myk410/Material-Weight-Calculator/README.md

# Material Weight Calculator

A standalone pocket calculator for estimating material weight. Select a material, enter length, width, and thickness in inches, and read the result in pounds. Runs entirely on one microcontroller with physical buttons and replaceable AAA batteries.

Status: **R3 LTC3440 buck-boost PCB implemented and CAD-validated, November 12, 2026; FABRICATION HOLD.** See [R3 review, evidence and unresolved physical checks](hardware/R3_REVIEW.md) and open [the R3 KiCad project](hardware/pcb/r3/material_weight_calculator.kicad_pro). Both current R3 boards use SMD resistors, capacitors, transistors, diodes and inductors; the purchased AVR DIP/socket and connectors are retained. See [owned-parts policy](hardware/OWNED_PARTS_AND_SMD.md). Main and display-adapter boards pass KiCad 9 ERC, DRC and schematic parity with zero violations. No R3 Gerbers/drills/order ZIP have been released because real-part mating and fit checks remain open. Existing R2 manufacturing archives use MCP1700 and must not be ordered as R3. Firmware, prototype operation and battery life remain untested.

## Proposed final low-power hardware

| Part | Proposed choice | Reason |
| --- | --- | --- |
| Controller | Microchip AVR128DA28, preferably the through-hole package for a hand-built prototype | One low-power microcontroller; enough RAM for a graphical display; internal oscillator; no wireless hardware needed |
| Display | EastRising ERC12864FS-655, 2.8-inch 128 × 64 positive monochrome LCD, no touch panel | Larger black-on-light screen; operate with backlight disconnected; separate UC1701 adapter PCB included |
| Buttons | Sixteen flexible-resin button caps over the user-owned DIYmalls 4 × 4 membrane keypad | Sixteen physical keys using eight controller pins; no separate keypad processor |
| Batteries | Three AAA alkaline cells in a replaceable holder | Switched supply; buck-boost conversion extends useful battery range, subject to diode drop and sag |
| Regulator | LTC3440EMS#PBF, MSOP-10, R3 | Nominal 3.3 V buck-boost with hand-solderable SMD supply components; see the R3 review for qualification limits |
| Supporting parts | Regulator input/output capacitors, local MCU decoupling, battery protection diode, display power transistor, service link, programming header | Reliable supply and a way to program the controller without leaving a USB interface powered |
| Housing | Rigid-resin printed calculator enclosure with accessible battery compartment | Large readable labels and easy battery replacement |

See [PARTS_LIST.md](PARTS_LIST.md) for previously purchased parts and the prototype route. The exact hardware R2 component and M2.5 fastener lists are in [hardware/README.md](hardware/README.md). The current R2 design uses the 70 × 50 mm EastRising display and a 70 × 18 mm adapter. The manufacturer lists up to 500 µA LCD current at 3.3 V; complete-device current and indoor readability still require a physical test.

The AVR128DA28 has 16 KB SRAM. A 128 × 64 monochrome framebuffer needs 1,024 bytes. PA1/PA2/PA3 drive clock/data/chip select, PA4 selects command/data, and PA5 resets the UC1701. The device needs firmware; the HTML calculator is a separate working example.

## Why memory LCD instead of e-paper?

| Display | Suitability |
| --- | --- |
| Reflective memory LCD | Recommended for calculator entry: quick digit updates, low power, readable by reflected light. Requires power and periodic display polarity inversion while displaying an image. |
| Black-and-white e-paper | Excellent for holding a result with display power removed. Updates are slower and may show ghosting or occasional full-screen flashes; partial-refresh behavior depends on the exact panel. |
| Reflective character LCD without a backlight | Worth considering if a cheaper, simpler text-only display is preferred. Select a specific low-power module before comparing total current; ordinary hobby modules are not all equally efficient. |

E-paper is compatible with a microcontroller and does not require a Raspberry Pi. For this device, fast keypad feedback makes memory LCD the stronger starting point. Neither unlit option is readable in darkness without external light.

## User operation

1. Press ON to wake the calculator.
2. Use MENU for material selection; 8/↑ and 2/↓ move through menus and ENTER selects. Default to the last material during the current powered session.
3. Choose solid rectangular stock or pipe using a short menu on the existing keypad.
4. For rectangular stock, enter length, width, and thickness in inches.
5. For pipe, enter length, actual outside diameter, and wall thickness (or inside diameter). Press ENTER after each input.
6. Show the material, dimensions, and estimated pounds, with the weight in the largest text.

Key functions: digits 0–9, decimal point, ENTER, MENU, BACK, CLEAR, and ON/OFF. This fits a 16-key matrix. The printed button caps will be made in rubbery resin, with recessed legends, and will actuate electrical switches underneath. See [MECHANICAL_DESIGN.md](MECHANICAL_DESIGN.md) for the key layout and printing requirements.

BACK deletes the last digit; with an empty field it returns to the previous field. CLEAR empties the current entry; on the result screen it starts a new piece while retaining the selected material and shape. ON/OFF puts the calculator to sleep. Do not use long-press combinations for routine entry. Start with decimal inches; fraction entry can be added if needed after testing the controls.

Reject empty fields, zero or negative dimensions, malformed numbers, overflow, and values beyond the supported input range. Display an explicit error instead of a plausible-looking weight. Always label the result as an estimate.

## Calculation and material data

For a solid rectangular piece:

`weight_lb = length_in × width_in × thickness_in × density_lb_per_ft3 / 1728`

Example using the published carbon-steel density of 7,850 kg/m³ (about 490.059 lb/ft³): a 12 × 12 × 1-inch plate weighs about 40.838 lb, displayed as `40.84 lb`.

The HTML now supports rectangular stock, pipe/round tube, and known volume. Pipe volume is `π × wall × (OD − wall) × length`, or equivalently `π/4 × (OD − ID) × (OD + ID) × length`. All dimensions are in decimal inches. Use actual diameters, not nominal pipe sizes. Pipe results exclude contents and fittings. Other hollow profiles and irregular parts need their own formulas.

At the user’s direction, the calculator replaces the company card values with published grade-specific densities. Material names now identify the grade, and separate presets cover LDPE/HDPE, 304/316 stainless, 718/625 nickel alloys, and 90/10 or 70/30 CuNi. Density overrides remain available for other grades. See [DENSITY_REVIEW.md](DENSITY_REVIEW.md) for active values, sources, and the historical card comparison. Do not use a broad material family as if every grade had the same density.

The handheld firmware should provide the same shape choices and density policy. Device firmware has not yet been implemented; the hardware pin map and power-control requirements are documented in hardware/README.md.

## Battery and sleep design

R3 uses three AAA alkaline cells through the physical slide switch, SS14 polarity diode and LTC3440 buck-boost supply. The regulated nominal output is 3.294 V. The converter's 2.5 V minimum applies at its VIN pin **after diode loss and battery sag**. The current EastRising UC1701 display is supplied from this rail through Q1; it has no Sharp-breakout regulator in this path.

The LTC3440's typical Burst Mode quiescent current is 25 µA, and the output divider adds about 6.1 µA. R3 therefore does not meet the old sub-10-µA automatic-sleep goal with its rail running; MCU and other leakage add to this. The slide switch provides hard battery disconnection. Whole-device current, stability and runtime remain unmeasured.

- While active, scan/debounce keys and update the UC1701 framebuffer. This display does not use the former Sharp memory-LCD VCOM servicing scheme.
- After about two minutes without input, save current state in RAM, blank the display, shut the display down according to its documentation, disable unused peripherals, and enter MCU power-down mode.
- If display power is switched off, put connected signal pins in a safe state to prevent back-powering. Reinitialize and redraw on wake.
- Wake from a keypad interrupt. In sleep, drive matrix columns low and use pulled-up interrupt-capable row inputs. Confirm exact AVR pin wake behavior before assigning pins. Consume the wake press so it does not enter a stray digit. Wait for key release before accepting another entry.
- Avoid continuous keypad polling during sleep, always-on LEDs, powered USB adapters, and continuously connected battery-sense resistor dividers.
- The case-mounted CYT1107 slide switch disconnects battery positive before main-board J2 pin 1; battery negative goes to J2 pin 2. JP1 remains an internal service link with its shunt normally fitted. The keypad ON/OFF key controls sleep only while the slide switch is ON. Hard power-off loses RAM state. See [power-switch wiring](hardware/POWER_SWITCH.md).

Battery-life estimates must use measured current for the complete assembly, including converter, divider, MCU and display. The former sub-10-µA automatic-sleep target is superseded by the R3 supply budget above; active current is also unverified.

Illustrative budget only: at 5 mA for 20 minutes per day plus 10 µA for the rest of the day, consumption is about 1.90 mAh/day. An assumed usable pack capacity of 800 mAh gives about 420 days arithmetically. Real runtime will depend on cutoff voltage, cell type, regulator dropout, temperature, leakage, and usage. Series-connected AAA cells raise voltage; their mAh capacities do not add.

## Build sequence

1. Confirm a readable display size and source the exact module.
2. Prototype the controller, display, and relabeled keypad. Use a detachable UPDI programmer; it is a setup tool, not part of the running device.
3. Implement the material menu, three input fields, calculation, and input validation. Check known rectangular-stock examples and custom density.
4. Implement keypad wake and display shutdown. Measure whole-device active and sleep current from the battery input.
5. Validate operation over the usable battery voltage range, including low-battery indication and clean handling of power loss.
6. Finalize the schematic, component list, firmware build instructions, and enclosure after these checks.

## Manufacturer references

- [Microchip AVR128DA28](https://www.microchip.com/en-us/product/AVR128DA28) and its linked datasheet: voltage limits, memory, sleep behavior, pin functions, and programming.
- [Analog Devices LTC3440](https://www.analog.com/en/products/ltc3440.html) and its linked datasheet: R3 regulator topology, pinout, compensation, layout and high-input protection. The preserved R2.1 design used MCP1700.
- [Waveshare e-paper manual](https://www.waveshare.com/wiki/2.13inch_e-Paper_HAT_Manual): refresh and standby considerations for an alternative display.
- [ATI corrosion-resistant titanium datasheet](https://www.atimaterials.com/Products/Documents/datasheets/titanium/alloyed/ati_corrosion_resistant_titanium%20_alloys_tds_en5_v1.pdf): grade-specific titanium density.

## Validation

Run `node tests/calculator.test.cjs` to check rectangular and pipe formulas, equivalent wall/ID inputs, published grade densities and replacement of the titanium misprint, input validation, override labeling, and mocked UI transitions. These checks pass. A real-browser check could not run in the current environment because the Chromium executable is unavailable; browser rendering and physical hardware remain unverified.

The display pin map, electrical source references, adapter BOM and 128 × 64 screen-layout requirements are in [hardware/DISPLAY_INTEGRATION.md](hardware/DISPLAY_INTEGRATION.md).
