myk410/Material-Weight-Calculator/hardware/POWER_SWITCH.md

# Hardware power switch

The Material Weight Calculator now uses the user-selected CYT1107 / WOWOONE-style 3-pin SPDT slide switch as the primary hard ON/OFF control for battery conservation.

## Selected switch

- Type: SPDT / 1P2T, three pins, two positions.
- Published body envelope: approximately 12.7 × 6.6 × 13.2 mm.
- Published actuator length: approximately 3.5 mm.
- Published terminal pitch: approximately 4.7 mm.
- The enclosure CAD includes a recessed side opening and an internal cradle sized around this envelope.
- Low-cost CYT1107-style switches can vary slightly, so trial-fit an actual switch before final curing/assembly if possible.

## Wiring as a hard power disconnect

Use the SPDT switch as a simple SPST disconnect:

```text
3 × AAA holder (+)
       |
       +---- CENTER / COMMON pin
                    |
                    | switch ON
                    v
             ONE OUTER pin ----> PCB J2 pin 1 (VBAT_SW)

OTHER OUTER pin: no connection

3 × AAA holder (-) ----------------> PCB J2 pin 2 (GND)
```

In the OFF position the common pin is connected to the unused outer pin, so battery positive is physically disconnected from the calculator electronics. This is preferred over relying only on MCU sleep when maximum battery conservation is wanted.

## Enclosure integration

The switch mount is in the upper-right side of the rear shell, above the main PCB zone and away from the AAA compartment. The actuator opening is recessed to reduce accidental switching. Internal end stops/cradle features support the switch body, and local ribs reinforce the side wall around the cutout to limit resin-print warping and flex.

The current CAD opening intentionally has some clearance. Confirm actual knob travel and molded body dimensions on one of the purchased switches before permanently bonding or potting the switch in place.

## Assembly notes

1. Trial-fit the switch in the rear-shell cradle.
2. Confirm both switch positions are reachable without the knob rubbing the resin slot.
3. Identify the center/common pin with a continuity meter if there is any doubt.
4. Solder AAA positive to common and the PCB-positive lead to the chosen outer pin.
5. Leave the other outer pin insulated and unconnected.
6. Route the negative battery lead directly to PCB J2 pin 2 (GND).
7. Add strain relief so wire motion does not load the three solder terminals.
8. Verify OFF gives an open circuit between battery positive and PCB positive before installing cells.

## R2.1 board integration

J2 pin 1 receives **switched** battery positive (VBAT_SW); pin 2 is ground. JP1 stays fitted as an internal service link, feeding D1 and the regulator. Do not put the slide switch across J2 pins 1 and 2: that would short the pack. The switch is case-mounted with short insulated leads; there is no CYT1107 footprint on either PCB. Its common-terminal identity must be confirmed with continuity rather than relying on the cheap switch family name.

The slide switch disconnects the battery source. A powered UPDI programmer connected to J4 can supply the board even when the switch is OFF. Remove the battery pack for programmer-powered use.
