myk410/Material-Weight-Calculator/hardware/docs/display_fit_template.pdf

## ERC12864FS-655 display fit check

Front view, actual size. Confirm module orientation and solder-pin reach before assembly.

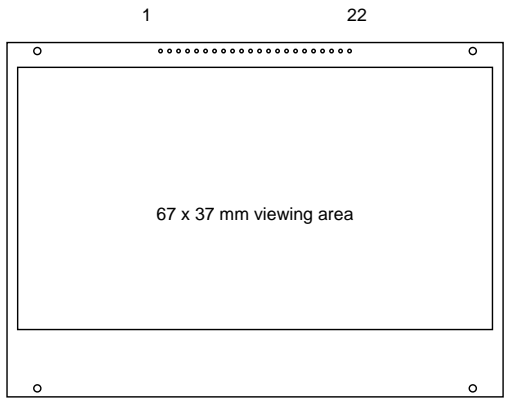
[picture p1: figure]
67 x 37 mm viewing area

100 mm scale check - print at Actual Size / 100%

Body: 70 x 50 x 5.8 mm maximum. Pin 1 to pin 22: 26.67 mm.
Use manufacturer drawing for pin bends and separate A/K backlight terminals. Case body origin: X13, Y7.5 mm. Window origin: X14.5, Y11 mm.
