myk410/Material-Weight-Calculator/hardware/docs/case_front_preview.png

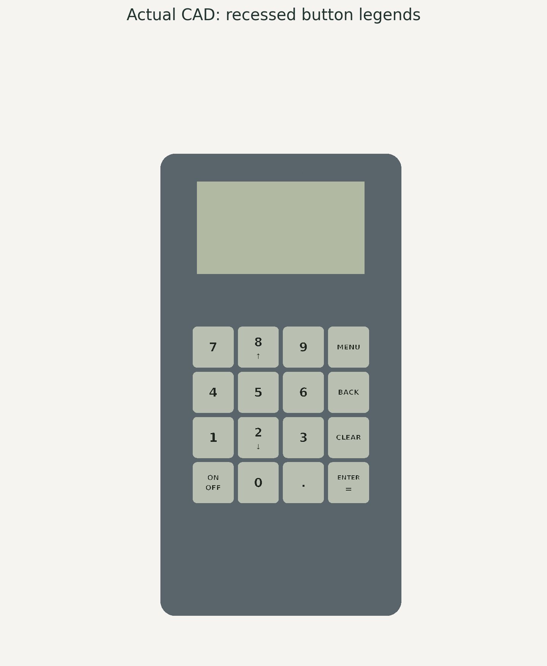
hardware/docs/case_front_preview.png
