myk410/Material-Weight-Calculator/PARTS_LIST.md

# Parts list — reuse existing parts first

Current R3 update, November 12, 2026: [owned parts retained and SMD policy](hardware/OWNED_PARTS_AND_SMD.md), [main BOM](hardware/pcb/r3/bom.csv), [SMD adapter BOM](hardware/pcb/r3/display_adapter/bom.csv). The older R2.1 shopping list below is historical; it does not describe the current SMD footprints. AVR128DA28-I/SP and ED281DT sockets are purchase-confirmed, five each.

Historical R2.1 inventory notes (November 2, 2026). The user confirmed owning the DIYmalls 4×4 membrane keypad shown in their screenshot. Relevant purchase records also identify Nano V3 boards, an ELEGOO Uno R3, HiLetgo ESP-WROOM-32 boards, ELEGOO jumper wires, and a five-piece I2C display-module order. Purchases establish prior acquisition, not that unused working spares remain available.

## Reuse for the first working prototype

| Qty | Part | Inventory evidence / use |
| ---: | --- | --- |
| 1 | DIYmalls 4×4, 16-key, 8-pin membrane keypad | Confirmed by user. Keep the entire membrane intact and conceal it under printed buttons. No sixteen-switch purchase needed. |
| 1 | Nano V3 / ATmega328P board | Prior purchase identified (LAFVIN listing B07G99NNXL). Compact controller for a first prototype using the small OLED. Check for a spare. |
| 1 | Small I2C OLED display module | Prior five-piece display-module order identified (B08L7QW7SR). The listing identifier appears to correspond to a 0.91-inch 128×32 SSD1306 OLED; confirm the physical module/controller and supply rating before wiring. Suitable for a compact, one-prompt-at-a-time UI test. |
| 10–14 | Dupont jumper leads | Prior ELEGOO 120-piece wire purchase identified (B01EV70C78). Eight keypad signal wires, two I2C signal wires, plus power/ground as needed. |
| 1 | USB cable matching the Nano | Check existing cables; used for programming and bench power. |
| 1 | Breadboard or temporary mounting board | Check parts bins; not confirmed in this inventory check. |

This prototype can test material selection, pipe/rectangular inputs, errors, button mechanics, and calculations without buying the previously proposed AVR or reflective display. The 128×32 screen requires a compact layout; it cannot show the full graphical simulator screen at once.

The Nano and its OLED are **not yet the final AAA power design**. A normal 5 V / 16 MHz Nano is not a drop-in match for the proposed 3.3 V rail. Do not feed a three-AAA pack into VIN and assume it provides regulated 5 V. A battery-powered Nano version would require a suitable supply and whole-board power measurements; its USB circuitry and LEDs may limit sleep savings.

An owned Uno can substitute on the bench. An owned ESP32 board is another prototype option, with a matching prototype display, but board-level regulator/USB/LED current must be assessed before using it for long battery life. No need to buy another ESP32 for this project.

## Final hardware R2 parts

The exact reference-designator BOM and 16-nut M2.5 fastener list are in [hardware/README.md](hardware/README.md); the machine-readable BOM is [hardware/pcb/bom.csv](hardware/pcb/bom.csv). The following summarizes what to locate or buy for that board.

| Qty | Part | Reuse / purchase status |
| ---: | --- | --- |
| 1 | Existing DIYmalls membrane keypad | Reuse confirmed. |
| 1 | AVR128DA28-I/SP | User is checking this exact 28-pin DIP version; not marked purchased. |
| 1 | 28-pin DIP socket, 7.62 mm row spacing | Check stock. |
| 1 | EastRising ERC12864FS-655, 2.8-inch LCD, no touch panel | Two purchased on eBay; one used. 70 × 50 × 5.8 mm body, 128 × 64 pixels. Backlight disconnected. |
| 1 | MCP1700-3302E/TO, 3.3 V | Check stock / likely purchase. |
| 1 | 1N5817 diode | Check stock; reverse-battery protection. |
| 1 | onsemi 2N3906 PNP transistor (E-B-C) | Check stock; display power switching. |
| 1 each | 10 kΩ and 100 kΩ axial resistors | Check stock. |
| 3 | TDK FG14X7R1H225KRT00, 2.2 µF 50 V X7R, 2.5 mm pitch | Main C1/C2/C5. Enlarged 4.5 × 3.0 mm body footprints; 5.5 mm maximum body height. |
| 2 | 100 nF ceramic capacitors, at least 10 V, 2.5 mm lead pitch | Check stock. |
| 1 | Three-AAA holder, nominal 52 × 37 × 13 mm (Pololu 1144 envelope) | Not confirmed owned. |
| 3 | AAA alkaline cells | Check stock. |
| 1 set | 2.54 mm headers: two 1×8, one 1×3, two 1×2; one shunt | **Keypad J1 requires an actual 1×8 male header**: the photographed keypad ribbon ends in a female 8-way housing. Verify 2.54 mm pitch and insertion direction before selecting straight vs right-angle; existing footprint is straight. Other headers: display cable, programmer, battery, master link. See [hardware/KEYPAD_CONNECTOR.md](hardware/KEYPAD_CONNECTOR.md). |
| 1 set | Existing jumper/hookup wire | Reuse where connectors fit. |
| 1 | Custom two-layer R2 PCB | Fabricate from included Gerbers/drills; PCB source and 1:1 copper artwork supplied. |
| 1 shared tool | 3 V SerialUPDI programmer | Adafruit UPDI Friend 5879 is a verified example. User also showed a generic switchable 3V/5V USB Serial UPDI board; correct type, specific seller's implementation unverified. CANADUINO's ATmega328P bootloader-only tool is incompatible. |
| 16 | M2.5 hex nuts | Glue into printed pockets; check existing stock. |
| 4 / 12 | M2.5 screws, 16 mm / 6 mm under-head lengths | Use existing matching lengths or obtain/trim as needed. |

Use the selected case-mounted CYT1107 SPDT slide switch as a hard battery disconnect: battery positive to common, one outer terminal to main J2.1, negative to J2.2. Insulate the unused outer terminal. JP1 is a separate internal service link, normally shunted. The keypad ON/OFF key controls sleep while the slide switch is ON. The discrete PNP transistor and two resistors implement the display switch, so no separate load-switch module is needed.

The 128 × 64 UC1701 display needs a 1,024-byte full framebuffer. Keep the selected AVR128DA28; compatibility with existing Nano/Uno prototypes is a separate firmware/electrical task.

Do not connect three fresh AAA cells directly to a bare 3 V display. Final power wiring must follow the selected module's voltage limits. Battery runtime remains unmeasured; the MCU's sleep specification alone is not the assembly's sleep current.

## Resin-printed parts

| Qty | Printed part | Material |
| ---: | --- | --- |
| 2 | Front shell sections with display bezel and sixteen button openings | Rigid resin |
| 2 | Rear shell sections | Rigid resin |
| 1 | Battery access cover | Rigid resin |
| 1 | Flat membrane-keypad backing plate | Rigid resin |
| 1 | Button guide/retainer | Rigid resin |
| 1 | Connected sixteen-key keypad sheet, recessed labels | 55A flexible resin; export/physical validation remains a mechanical task |
| 1 | R2 rear display cradle | Rigid resin |

Use the already-established key layout from [MECHANICAL_DESIGN.md](MECHANICAL_DESIGN.md). Keep the buttons aligned over the existing membrane's key centers and remap their electrical positions in firmware. No need to expose the membrane's original printed labels.

## Suggested purchase order

1. Locate one spare Nano, one matching OLED, existing leads, and the confirmed keypad. Test the UI and printed button coupon using USB power.
2. Check stock for the small passive parts, AAA holder, connectors, and screws.
3. Source the selected ERC12864FS-655 (without touch), AVR128DA28-I/SP, and compatible 3 V UPDI programmer. Check both PCB BOMs and display pin fit before ordering/fabricating.

## Technical references

- [Arduino classic Nano specifications](https://store.arduino.cc/products/arduino-nano): 5 V operation and 2 KB SRAM. The user's clone requires confirmation against its actual board.
- [Microchip AVR128DA28 datasheet](https://ww1.microchip.com/downloads/aemDocuments/documents/MCU08/ProductDocuments/DataSheets/AVR128DA28-32-48-64-Data-Sheet-DS40002183.pdf): memory, packages, voltage limits, and programming.
- [Microchip MCP1700 datasheet](https://www.microchip.com/content/dam/mchp/documents/APID/ProductDocuments/DataSheets/MCP1700-Data-Sheet-20001826F.pdf): regulator options, package pinouts, and required capacitors.
- [Parallax membrane keypad reference](https://www.parallax.com/products/4x4-matrix-membrane-keypad): similar 8-pin matrix construction. Its dimensions and pinout are not a verified drawing for the user's DIYmalls pad.

Exact key pitch, active contact centers, ribbon exit, connector pinout, display variant, and mounting geometry must be established from the actual selected parts or their matching drawings before final CAD. The screenshot is sufficient to identify the keypad type, not its fabrication dimensions.

## R2 display adapter additions

Fabricate the separate 70 × 18 mm display adapter. Use 22 holes at 1.27 mm pitch for the module pins; solder seven short wires from adapter J1 to main J3. Add 2 × TDK FG14X7R1H225KRT00 (2.2 µF 50 V X7R), 1 × 330 nF 25 V ceramic, 1 × 100 nF ceramic, 1 × 10 µF 16 V low-leakage electrolytic (4 mm diameter, ≤7 mm high), and 1 × 10 MΩ axial resistor. Use 0.5 mm closed-cell foam strips on the opaque display-frame perimeter. No touch panel, backlight driver or Sharp module is required. Order parts against both `hardware/pcb/bom.csv` and `hardware/pcb/display_adapter/bom.csv`.

The CYT1107 hard switch is an external assembly component and does not appear as a PCB-mounted part in the board BOM. Review [PCB_REVIEW.md](hardware/PCB_REVIEW.md) for remaining component selection and physical checks.
