myk410/Material-Weight-Calculator/hardware/pcb/r3/bom.csv

Reference | Value | Footprint | ManufacturerPartNumber
U1 | AVR128DA28-I/SP | MW_footprints:DIP-28_W7.62mm
J1 | KEYPAD_8PIN | MW_footprints:PinHeader_1x08_P2.54mm_Vertical
J2 | SWITCHED_3AAA_IN | MW_footprints:PinHeader_1x02_P2.54mm_Vertical
JP1 | MASTER_LINK | MW_footprints:PinHeader_1x02_P2.54mm_Vertical
J3 | UC1701_ADAPTER_CABLE | MW_footprints:PinHeader_1x08_P2.54mm_Vertical
J4 | UPDI_3V3 | MW_footprints:PinHeader_1x03_P2.54mm_Vertical
H1 | M2.5 | MW_footprints:MountingHole_2.7mm_M2.5
H2 | M2.5 | MW_footprints:MountingHole_2.7mm_M2.5
H3 | M2.5 | MW_footprints:MountingHole_2.7mm_M2.5
H4 | M2.5 | MW_footprints:MountingHole_2.7mm_M2.5
U2 | LTC3440EMS#PBF | MW_footprints:MSOP-10_3x3mm_P0.5mm | LTC3440EMS#PBF
L1 | 10uH | MW_footprints:L_CDRH6D38_HandSolder | CDRH6D38NP-100NC
D1 | SS14 | MW_footprints:D_SMA | SS14
C1 | 10uF 25V X7R | MW_footprints:C_1206_3216Metric_Pad1.33x1.80mm_HandSolder | GRM31CR71E106KA12L
C2 | 22uF 25V X7R | MW_footprints:C_1210_3225Metric_Pad1.33x2.70mm_HandSolder | GRM32ER71E226KE15L
R3 | 60.4k 1% | MW_footprints:R_0805_2012Metric_Pad1.20x1.40mm_HandSolder | RC0805FR-0760K4L
R4 | 340k 1% | MW_footprints:R_0805_2012Metric_Pad1.20x1.40mm_HandSolder | RC0805FR-07340KL
R5 | 200k 1% | MW_footprints:R_0805_2012Metric_Pad1.20x1.40mm_HandSolder | RC0805FR-07200KL
R6 | 15k 1% | MW_footprints:R_0805_2012Metric_Pad1.20x1.40mm_HandSolder | RC0805FR-0715KL
C6 | 1.5nF C0G 50V | MW_footprints:C_0805_2012Metric_Pad1.18x1.45mm_HandSolder | GRM2165C1H152JA01D
R8 | 0R | MW_footprints:R_0805_2012Metric_Pad1.20x1.40mm_HandSolder | RC0805JR-070RL
D2 | PMEG2010ER | MW_footprints:Nexperia_CFP3_SOD-123W | PMEG2010ER,115
R7 | 2R 1% | MW_footprints:R_0805_2012Metric_Pad1.20x1.40mm_HandSolder | RC0805FR-072RL
C7 | 1nF C0G 50V | MW_footprints:C_0805_2012Metric_Pad1.18x1.45mm_HandSolder | GRM2165C1H102JA01D
TP1 | VIN | MW_footprints:TestPoint_Pad_D2.0mm
TP2 | GND | MW_footprints:TestPoint_Pad_D2.0mm
TP3 | +3V3 | MW_footprints:TestPoint_Pad_D2.0mm
C3 | 100nF 25V X7R | MW_footprints:C_0603_1608Metric_Pad1.08x0.95mm_HandSolder | GRM188R71E104KA01D
C4 | 100nF 25V X7R | MW_footprints:C_0603_1608Metric_Pad1.08x0.95mm_HandSolder | GRM188R71E104KA01D
C5 | 2.2uF 25V X5R | MW_footprints:C_0603_1608Metric_Pad1.08x0.95mm_HandSolder | GRM188R61E225KA12D
R1 | 10k 1% | MW_footprints:R_0603_1608Metric_Pad0.98x0.95mm_HandSolder | RC0603FR-0710KL
R2 | 100k 1% | MW_footprints:R_0603_1608Metric_Pad0.98x0.95mm_HandSolder | RC0603FR-07100KL
Q1 | MMBT3906LT1G | MW_footprints:SOT-23_Handsoldering | MMBT3906LT1G
J5 | UPDI_JST_PH_2MM | MW_footprints:JST_PH_B3B-PH-K_1x03_P2.00mm_Vertical | B3B-PH-K-S(LF)(SN)
