myk410/Material-Weight-Calculator/hardware/pcb/display_adapter/bom.csv

Reference | Value | Footprint | ManufacturerPartNumber
J2 | ERC12864FS-655 | MW_footprints:PinHeader_1x22_P1.27mm_Vertical
J1 | MAIN_J3_CABLE | MW_footprints:PinHeader_1x08_P2.54mm_Vertical
C1 | 2.2uF 50V X7R | MW_footprints:C_Radial_L4.5mm_W3.0mm_P2.50mm | FG14X7R1H225KRT00
C2 | 2.2uF 50V X7R | MW_footprints:C_Radial_L4.5mm_W3.0mm_P2.50mm | FG14X7R1H225KRT00
C3 | 330nF 25V | MW_footprints:C_Disc_D3.0mm_W1.6mm_P2.50mm
C4 | 100nF 25V | MW_footprints:C_Disc_D3.0mm_W1.6mm_P2.50mm
C5 | 10uF 16V low leakage | MW_footprints:CP_Radial_D4.0mm_P1.50mm
R1 | 10M | MW_footprints:R_Axial_DIN0207_L6.3mm_D2.5mm_P7.62mm_Horizontal
H1 | LCD_NC_CLEARANCE | MW_footprints:MountingHole_2.1mm
H2 | LCD_NC_CLEARANCE | MW_footprints:MountingHole_2.1mm
