myk410/Material-Weight-Calculator/hardware/cad/rear_shell_whole_reference.stl

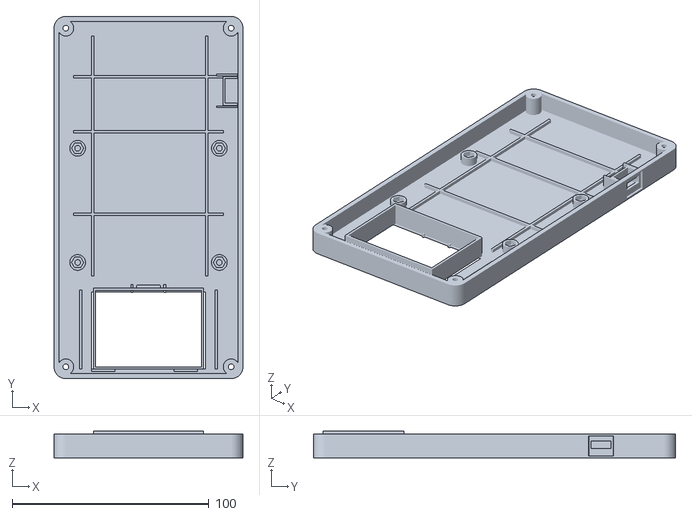
[picture p3: CAD file, 2026-11-02]
hardware/cad/rear_shell_whole_reference.stl
96.0 x 184.0 x 13.5
