myk410/Material-Weight-Calculator/hardware/cad/calculator_assembly.step

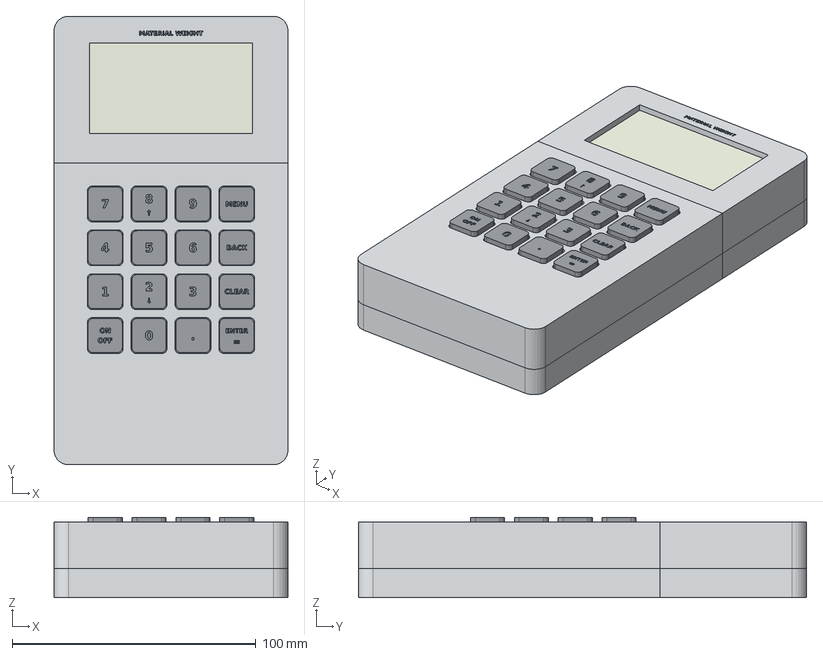
[picture p4: CAD file, 2026-10-27]
hardware/cad/calculator_assembly.step
96.0 x 184.0 x 33.0 mm
battery_cover
keypad_backing
keypad_guide
display_cradle
button_r1c1_7
button_r1c2_8
button_r1c3_9
button_r1c4_menu
button_r2c1_4
button_r2c2_5
button_r2c3_6
button_r2c4_back
button_r3c1_1
button_r3c2_2
button_r3c3_3
button_r3c4_clear
button_r4c1_on
button_r4c2_0
button_r4c3_decimal
button_r4c4_enter
mars_front_upper
mars_front_lower
mars_rear_upper
mars_rear_lower
LCD_reference_not_for_printing
adapter_PCB_reference_not_for_printing
