myk410/Material-Weight-Calculator/hardware/cad/front_shell_whole_reference.stl

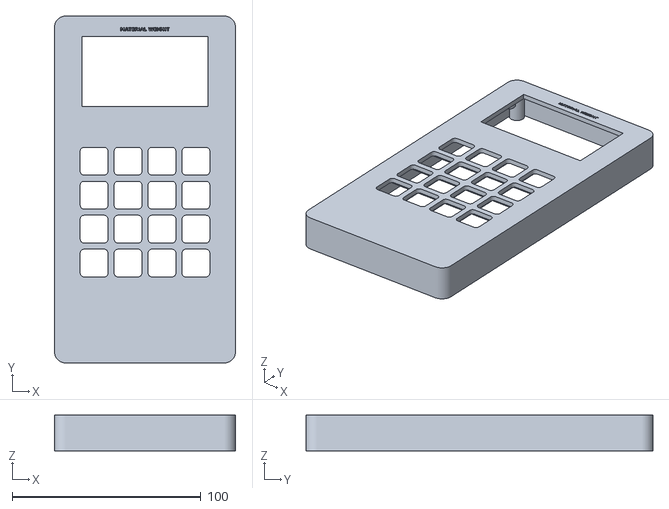
[picture p5: CAD file, 2026-10-27]
hardware/cad/front_shell_whole_reference.stl
96.0 x 184.0 x 19.0
