myk410/Material-Weight-Calculator/hardware/stl/mars5_ultra_oriented/mars_rear_lower.stl

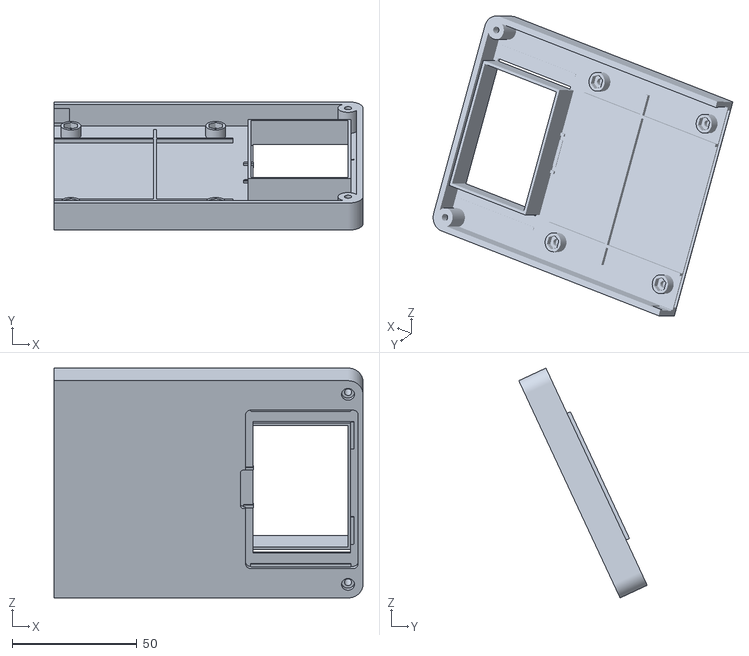
[picture p6: CAD file, 2026-11-02]
hardware/stl/mars5_ultra_oriented/mars_rear_lower.stl
123.8 x 51.4 x 92.1
