myk410/Material-Weight-Calculator/hardware/stl/mars_rear_lower.stl

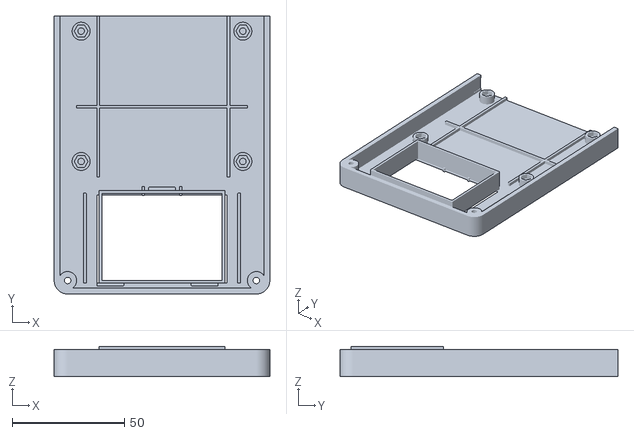
[picture p7: CAD file, 2026-11-02]
hardware/stl/mars_rear_lower.stl
96.0 x 123.8 x 13.5
