myk410/Material-Weight-Calculator/hardware/stl/mars5_ultra_oriented/mars_rear_upper.stl

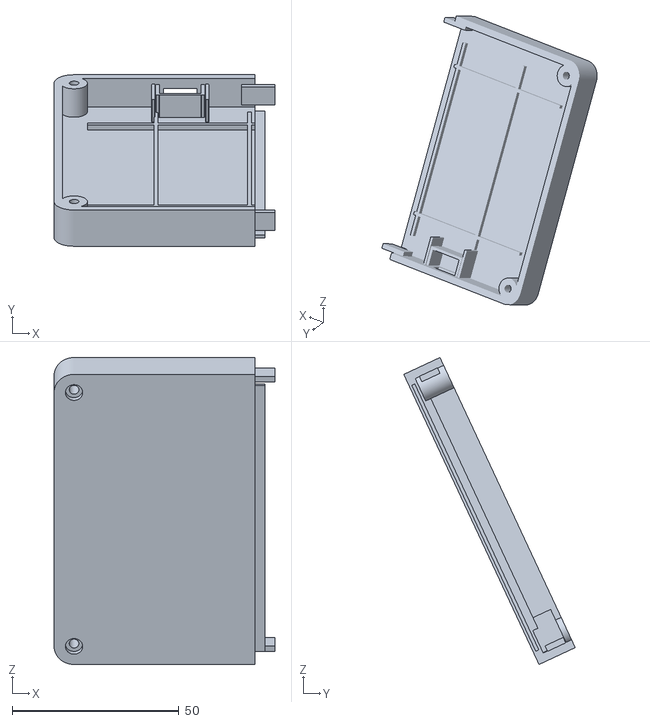
[picture p8: CAD file, 2026-11-02]
hardware/stl/mars5_ultra_oriented/mars_rear_upper.stl
66.2 x 51.4 x 92.1
