myk410/Material-Weight-Calculator/hardware/stl/mars_rear_upper.stl

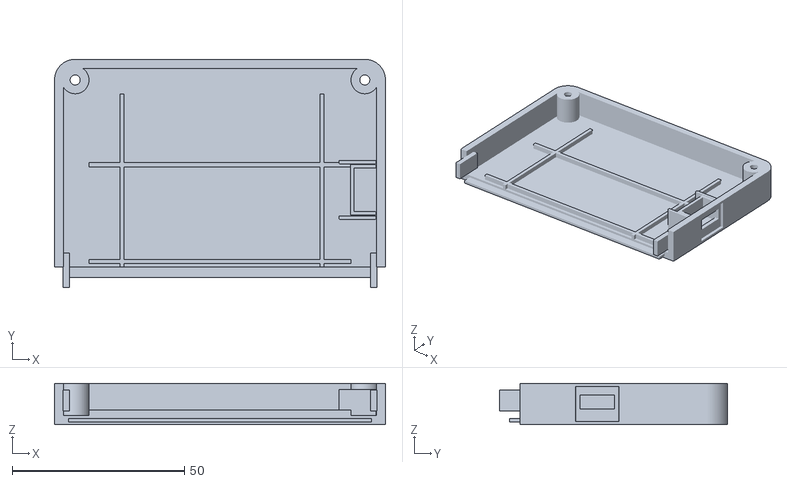
[picture p9: CAD file, 2026-11-02]
hardware/stl/mars_rear_upper.stl
96.0 x 66.2 x 12.0
