myk410/Material-Weight-Calculator/hardware/cad/display_adapter_outline.step

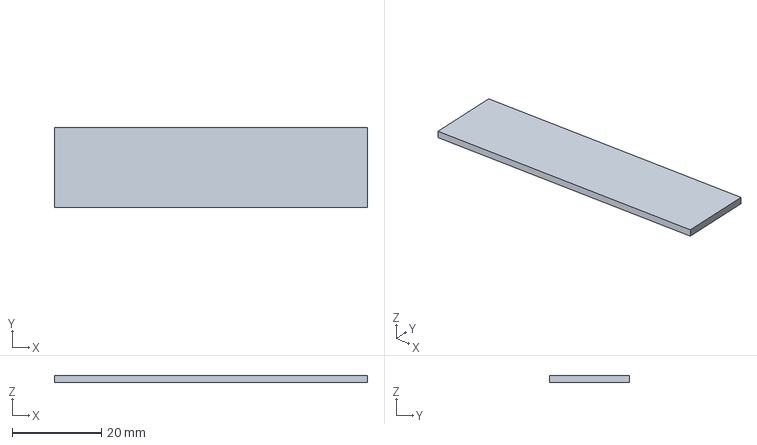
[picture p10: CAD file, 2026-10-27]
hardware/cad/display_adapter_outline.step
70.0 x 18.0 x 1.60 mm
