myk410/Material-Weight-Calculator/hardware/stl/battery_cover.stl

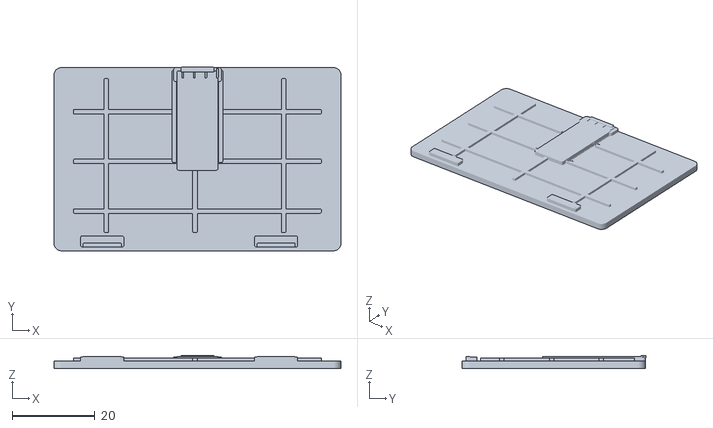
[picture p11: CAD file, 2026-10-30]
hardware/stl/battery_cover.stl
69.3 x 44.3 x 3.10
