myk410/Material-Weight-Calculator/hardware/stl/mars5_ultra_oriented/mars_front_upper.stl

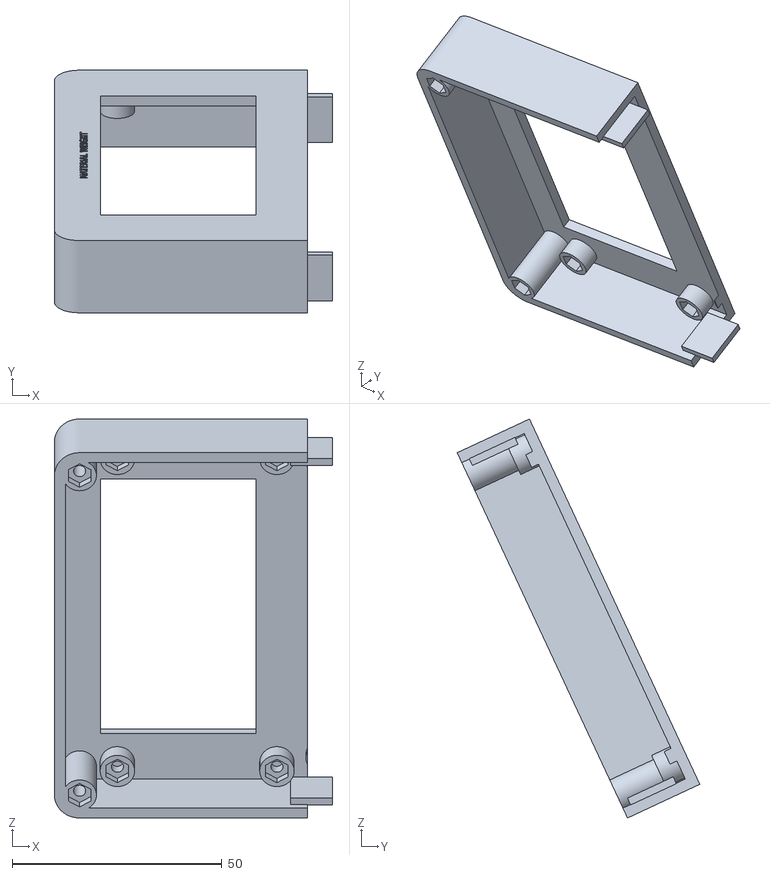
[picture p12: CAD file, 2026-10-27]
hardware/stl/mars5_ultra_oriented/mars_front_upper.stl
66.2 x 57.8 x 95.0
