myk410/Material-Weight-Calculator/hardware/cad/pcb_outline.step

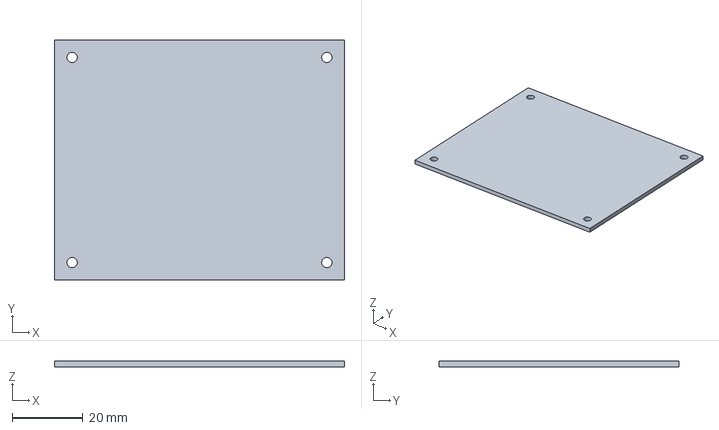
[picture p13: CAD file, 2026-10-27]
hardware/cad/pcb_outline.step
82.0 x 68.0 x 1.60 mm
