myk410/Material-Weight-Calculator/hardware/stl/mars5_ultra_oriented/mars_front_lower.stl

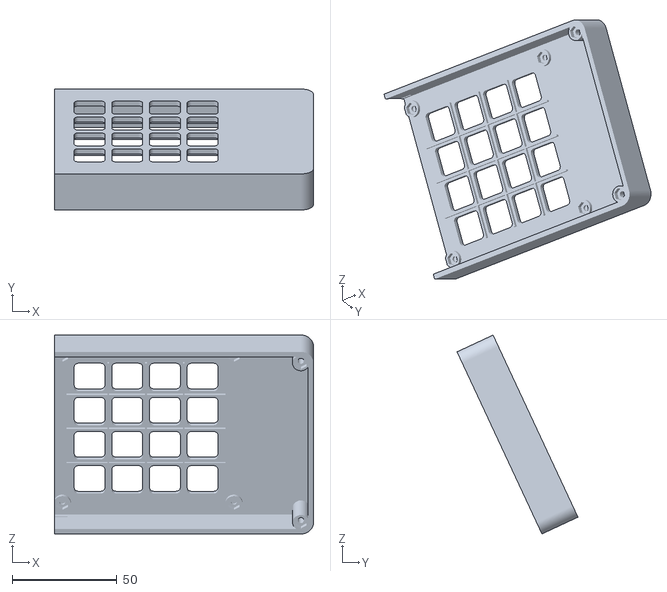
[picture p14: CAD file, 2026-10-27]
hardware/stl/mars5_ultra_oriented/mars_front_lower.stl
123.8 x 57.8 x 95.0
