myk410/Material-Weight-Calculator/hardware/stl/mars_front_upper.stl

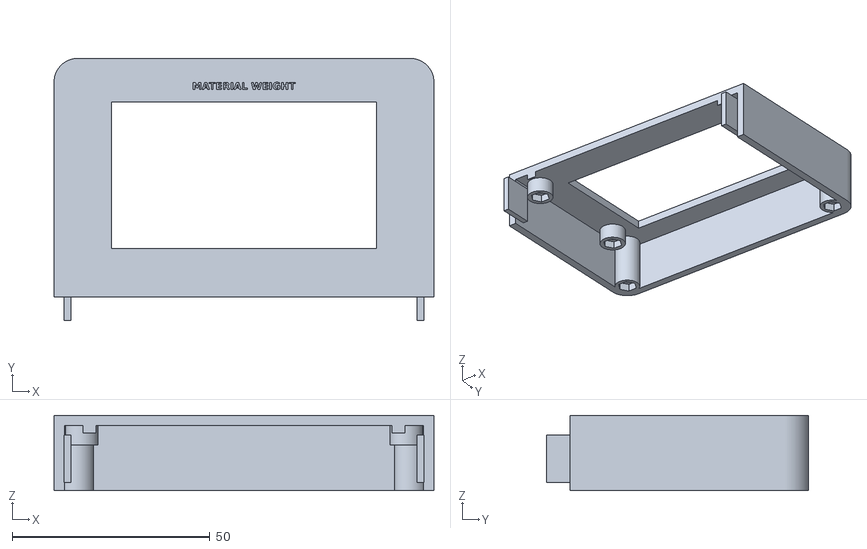
[picture p15: CAD file, 2026-10-27]
hardware/stl/mars_front_upper.stl
96.0 x 66.2 x 19.0
