myk410/Material-Weight-Calculator/hardware/stl/mars5_ultra_oriented/keypad_guide.stl

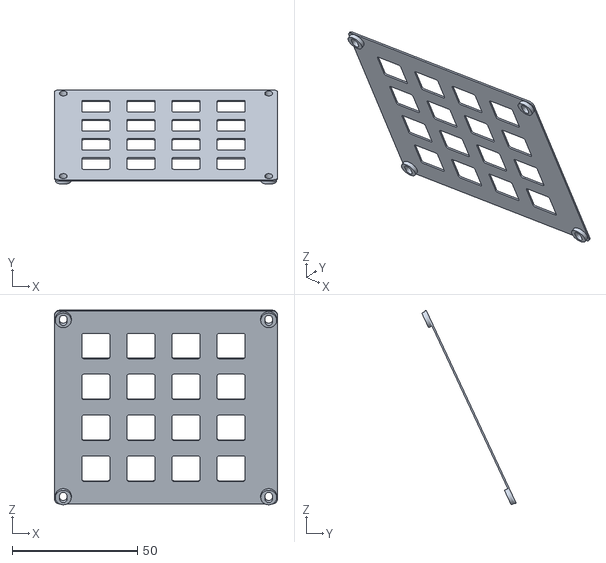
[picture p16: CAD file, 2026-10-27]
hardware/stl/mars5_ultra_oriented/keypad_guide.stl
89.0 x 37.7 x 77.7
