myk410/Material-Weight-Calculator/hardware/stl/mars_front_lower.stl

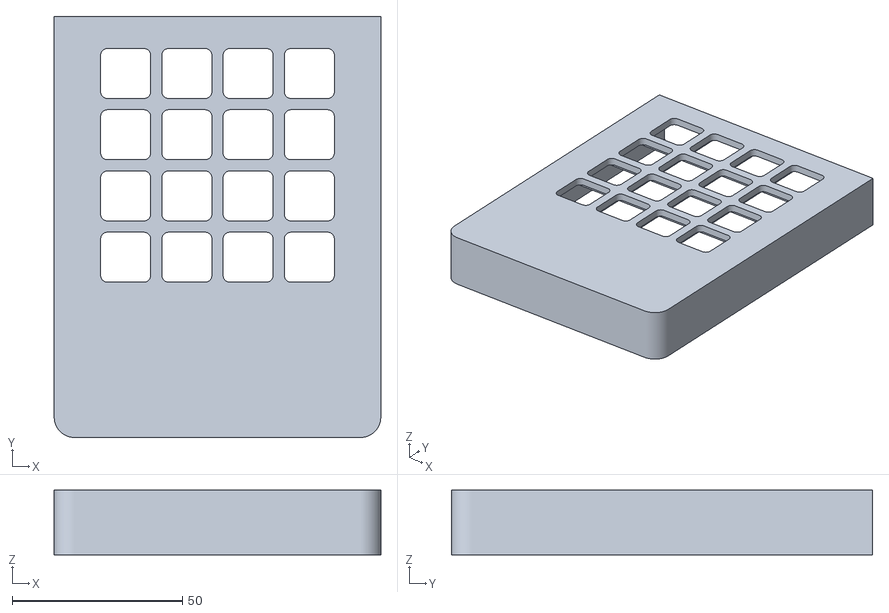
[picture p17: CAD file, 2026-10-27]
hardware/stl/mars_front_lower.stl
96.0 x 123.8 x 19.0
