myk410/Material-Weight-Calculator/hardware/stl/display_cradle.stl

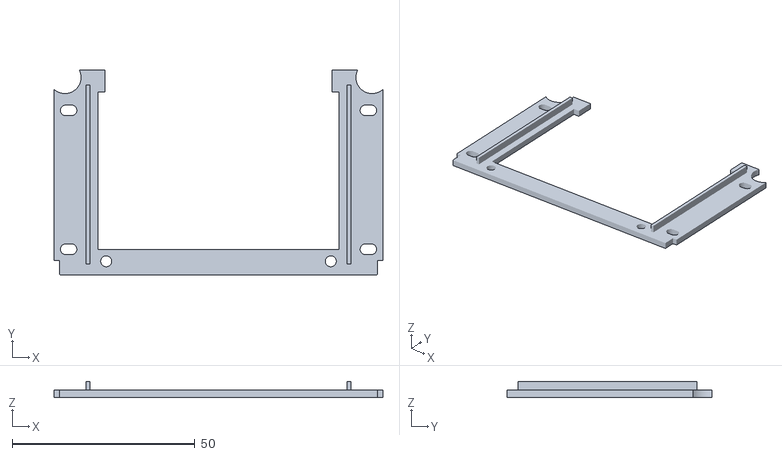
[picture p18: CAD file, 2026-10-27]
hardware/stl/display_cradle.stl
90.0 x 56.0 x 4.40
