myk410/Material-Weight-Calculator/hardware/stl/mars5_ultra_oriented/keypad_backing.stl

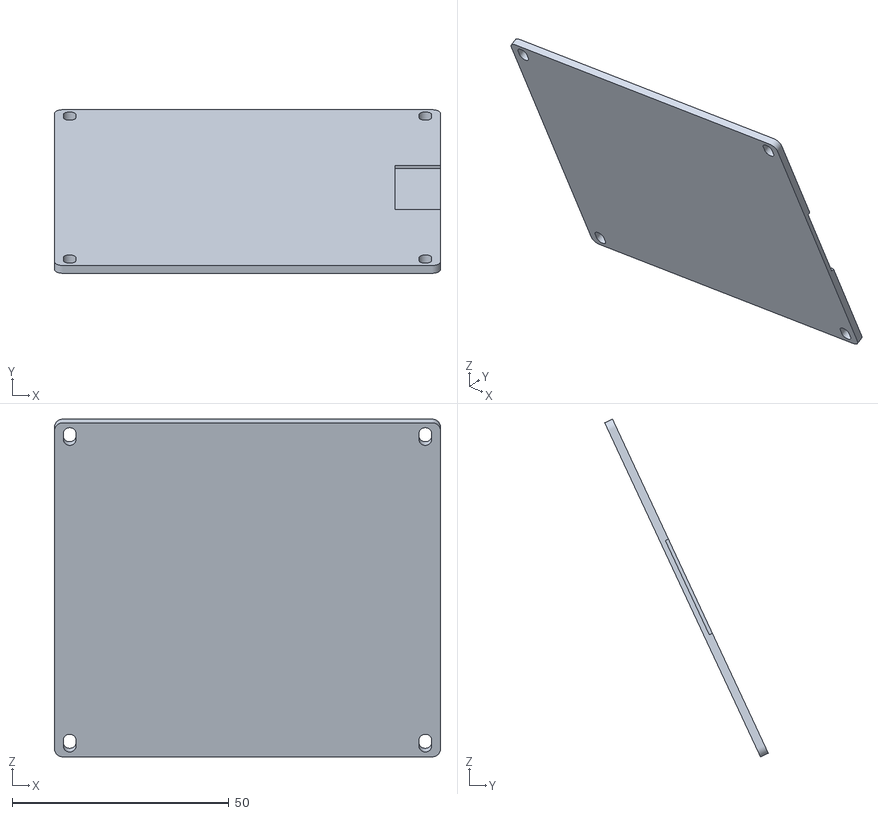
[picture p19: CAD file, 2026-10-27]
hardware/stl/mars5_ultra_oriented/keypad_backing.stl
89.0 x 37.7 x 77.9
