myk410/Material-Weight-Calculator/hardware/stl/button_r1c4_menu.stl

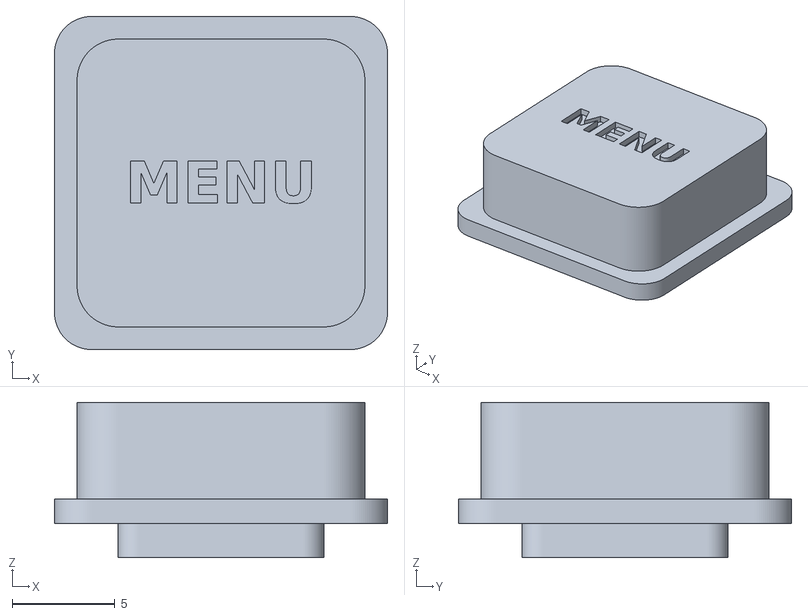
[picture p21: CAD file, 2026-10-27]
hardware/stl/button_r1c4_menu.stl
16.2 x 16.2 x 7.55
