myk410/Material-Weight-Calculator/hardware/stl/all_16_buttons.stl

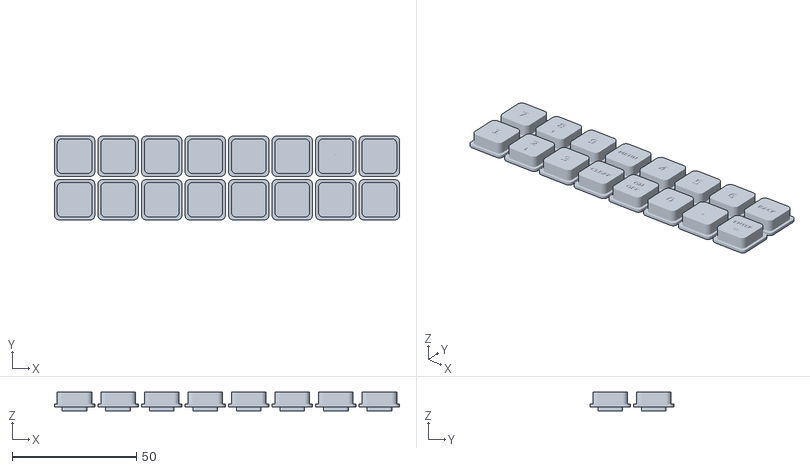
[picture p22: CAD file, 2026-10-27]
hardware/stl/all_16_buttons.stl
138.7 x 33.7 x 7.55
