myk410/Material-Weight-Calculator/hardware/stl/keypad_backing.stl

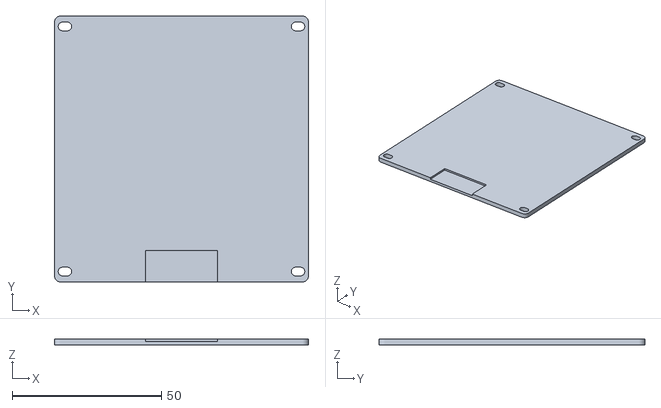
[picture p23: CAD file, 2026-10-27]
hardware/stl/keypad_backing.stl
85.0 x 89.0 x 2.00
