myk410/Material-Weight-Calculator/hardware/stl/button_r4c4_enter.stl

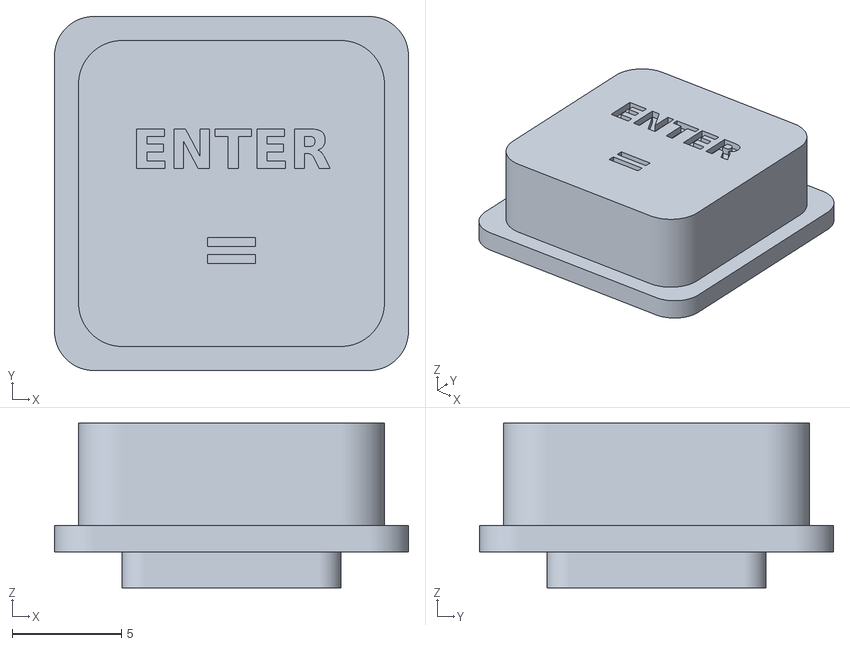
[picture p24: CAD file, 2026-10-27]
hardware/stl/button_r4c4_enter.stl
16.2 x 16.2 x 7.55
