myk410/Material-Weight-Calculator/hardware/stl/fit_coupon_face.stl

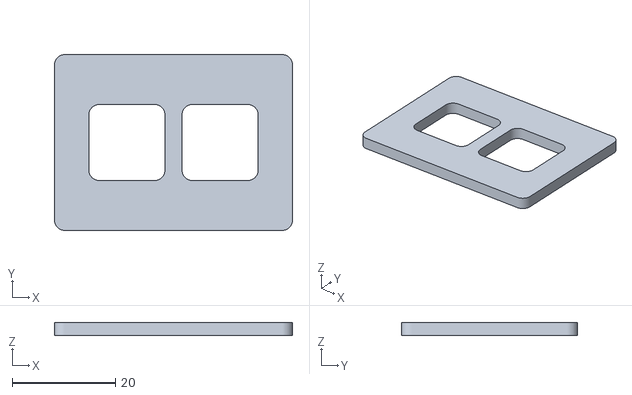
[picture p25: CAD file, 2026-10-27]
hardware/stl/fit_coupon_face.stl
46.0 x 34.0 x 2.60
