myk410/Material-Weight-Calculator/hardware/stl/fit_coupon_guide.stl

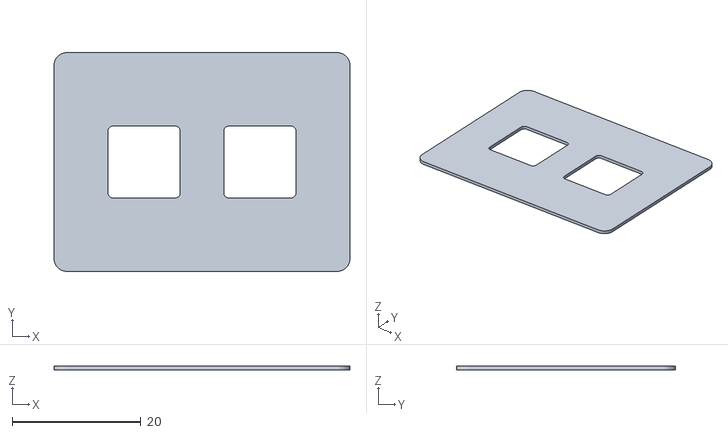
[picture p26: CAD file, 2026-10-27]
hardware/stl/fit_coupon_guide.stl
46.0 x 34.0 x 0.6
