myk410/Material-Weight-Calculator/hardware/stl/fit_coupon_nuts.stl

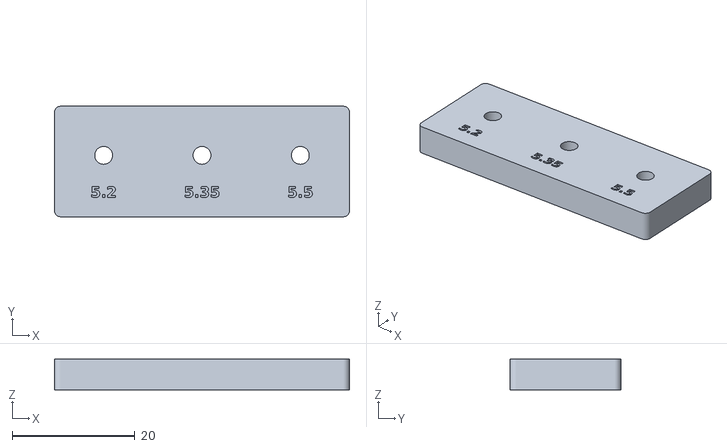
[picture p27: CAD file, 2026-10-27]
hardware/stl/fit_coupon_nuts.stl
48.0 x 18.0 x 5.00
