myk410/Material-Weight-Calculator/hardware/stl/keypad_guide.stl

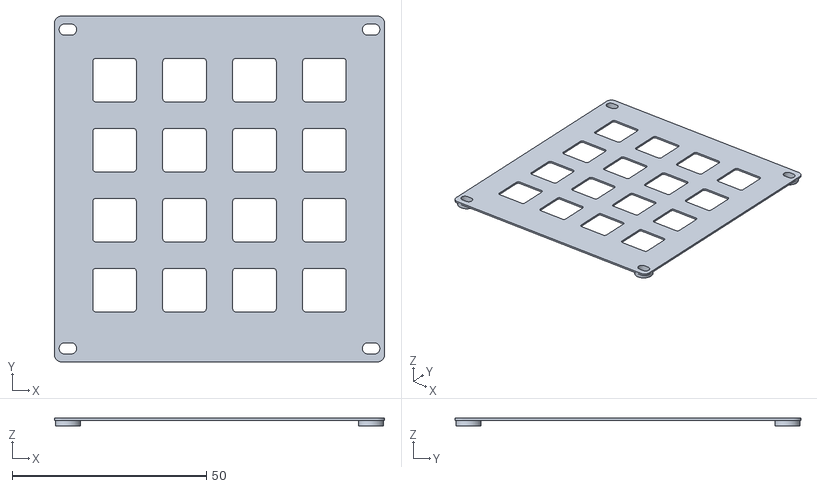
[picture p28: CAD file, 2026-10-27]
hardware/stl/keypad_guide.stl
85.0 x 89.0 x 2.10
