myk410/Material-Weight-Calculator/(list of files, cad)

Other CAD files:
hardware/stl/button_r2c2_5.stl
hardware/stl/button_r2c3_6.stl
hardware/stl/button_r1c2_8.stl
hardware/stl/button_r2c1_4.stl
hardware/stl/button_r4c3_decimal.stl
hardware/stl/button_r3c2_2.stl
hardware/stl/button_r1c3_9.stl
hardware/stl/button_r3c4_clear.stl
hardware/stl/button_r3c1_1.stl
hardware/stl/button_r4c1_on.stl
hardware/stl/button_r2c4_back.stl
hardware/stl/button_r1c1_7.stl
hardware/stl/button_r3c3_3.stl
