myk410/Material-Weight-Calculator/hardware/pcb/gerbers/FABRICATION.txt

Material Weight Calculator R2.1 PROTOTYPE
82 x 68 mm; 2 copper layers; 1.6 mm FR-4; plated through holes.
Separate PTH/NPTH Excellon drills. 0.4 mm tracks; 0.25 mm clearance; 1.0/0.5 mm vias.
No electrical prototype has been bench tested. See hardware/PCB_REVIEW.md for component/fit gates.
