myk410/Material-Weight-Calculator/hardware/docs/assembly_exploded_preview.png

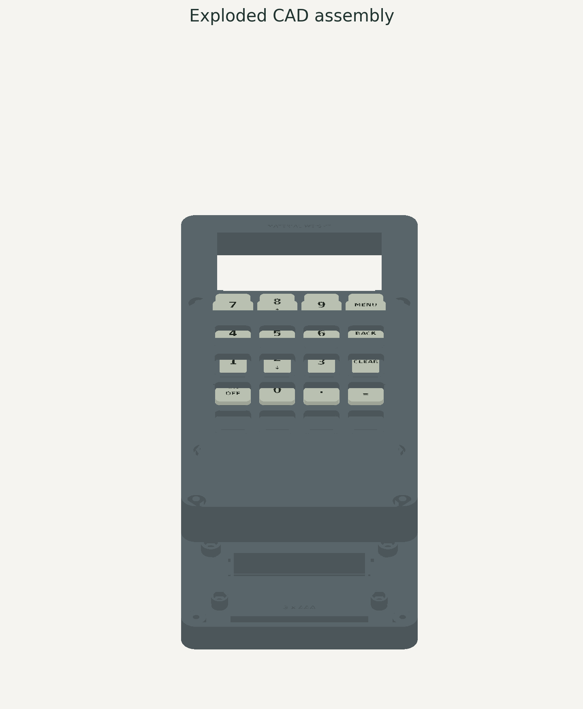
hardware/docs/assembly_exploded_preview.png
