myk410/Material-Weight-Calculator/hardware/validation/r3/orientation_pins.csv

Board | Reference | Pin | Net | InstalledFrom | TopX_mm | TopY_mm | UndersideX_mm | UndersideY_mm
main | C1 | 1 | VIN | F.Cu | 31.0 | 17.0625 | 51.0 | 17.0625
main | C1 | 2 | GND | F.Cu | 31.0 | 13.9375 | 51.0 | 13.9375
main | C2 | 1 | +3V3 | F.Cu | 29.4375 | 20.0 | 52.5625 | 20.0
main | C2 | 2 | GND | F.Cu | 32.5625 | 20.0 | 49.4375 | 20.0
main | C3 | 1 | +3V3 | F.Cu | 46.1375 | 39.0 | 35.8625 | 39.0
main | C3 | 2 | GND | F.Cu | 47.8625 | 39.0 | 34.1375 | 39.0
main | C4 | 1 | +3V3 | F.Cu | 33.1375 | 58.0 | 48.8625 | 58.0
main | C4 | 2 | GND | F.Cu | 34.8625 | 58.0 | 47.1375 | 58.0
main | C5 | 1 | LCD_VCC | F.Cu | 63.1375 | 12.0 | 18.8625 | 12.0
main | C5 | 2 | GND | F.Cu | 64.8625 | 12.0 | 17.1375 | 12.0
main | C6 | 1 | COMP_NODE | F.Cu | 25.9625 | 10.0 | 56.0375 | 10.0
main | C6 | 2 | FB | F.Cu | 28.0375 | 10.0 | 53.9625 | 10.0
main | C7 | 1 | SNUB | F.Cu | 20.9625 | 26.5 | 61.0375 | 26.5
main | C7 | 2 | GND | F.Cu | 23.0375 | 26.5 | 58.9625 | 26.5
main | D1 | 1 | VIN | F.Cu | 12.0 | 5.0 | 70.0 | 5.0
main | D1 | 2 | VBAT_LINK | F.Cu | 16.0 | 5.0 | 66.0 | 5.0
main | D2 | 1 | VIN | F.Cu | 26.4 | 22.5 | 55.6 | 22.5
main | D2 | 2 | SW1 | F.Cu | 23.6 | 22.5 | 58.4 | 22.5
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
