myk410/Material-Weight-Calculator/hardware/docs/copper_artwork_1to1.pdf

## Top copper - component-side reference

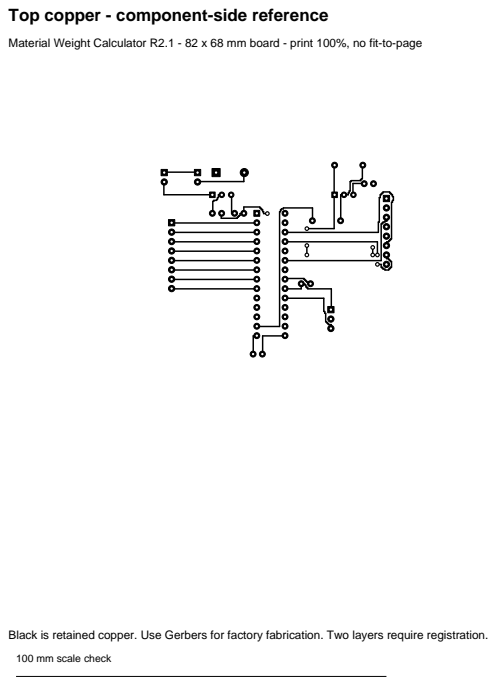
[picture p30: page 1]

Material Weight Calculator R2.1 - 82 x 68 mm board - print 100%, no fit-to-page

Black is retained copper. Use Gerbers for factory fabrication. Two layers require registration.
100 mm scale check

## Top copper - MIRRORED toner-transfer mask

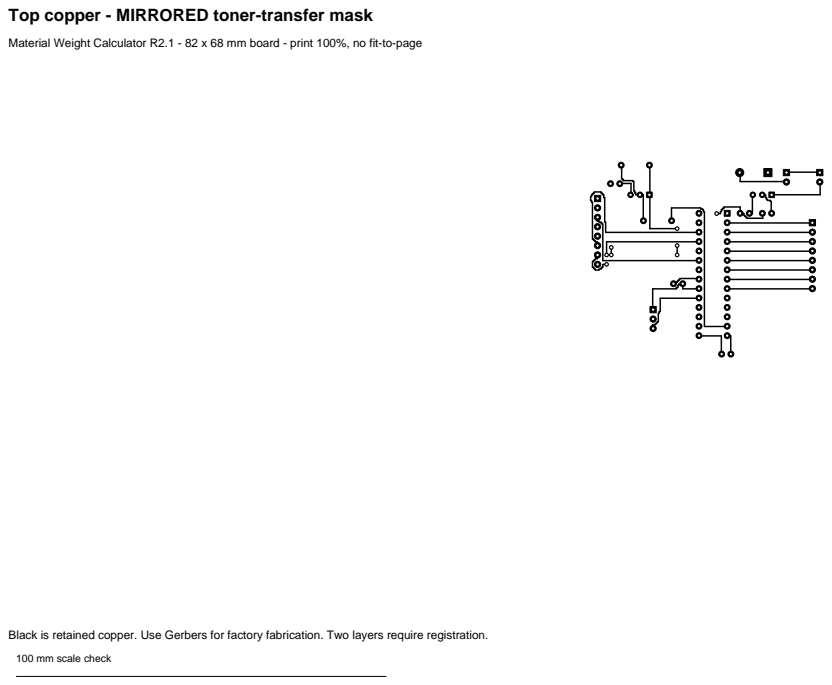
[picture p31: page 2]

Material Weight Calculator R2.1 - 82 x 68 mm board - print 100%, no fit-to-page

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

## Bottom copper - viewed from underside

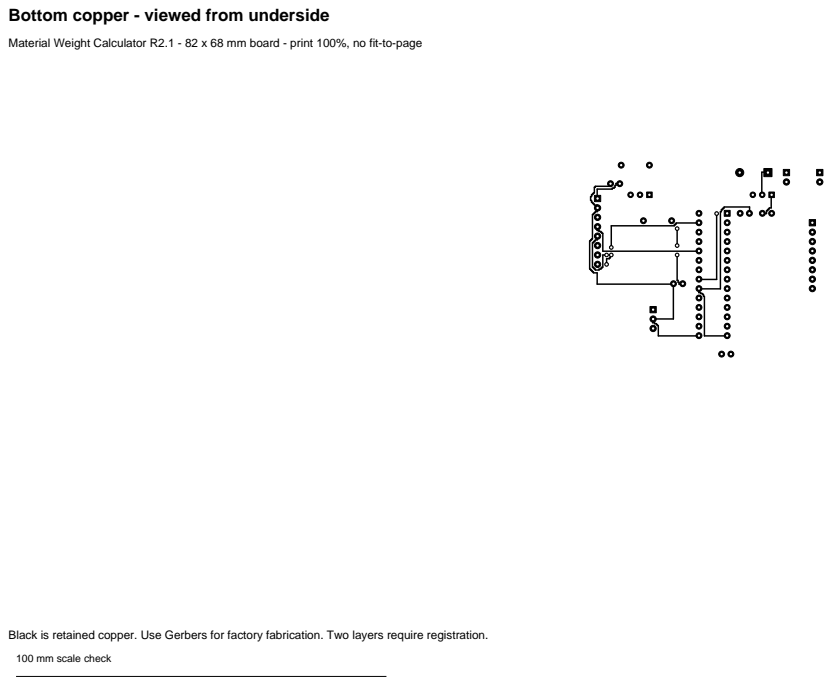
[picture p32: page 3]

Material Weight Calculator R2.1 - 82 x 68 mm board - print 100%, no fit-to-page

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

## Bottom copper - toner-transfer mask

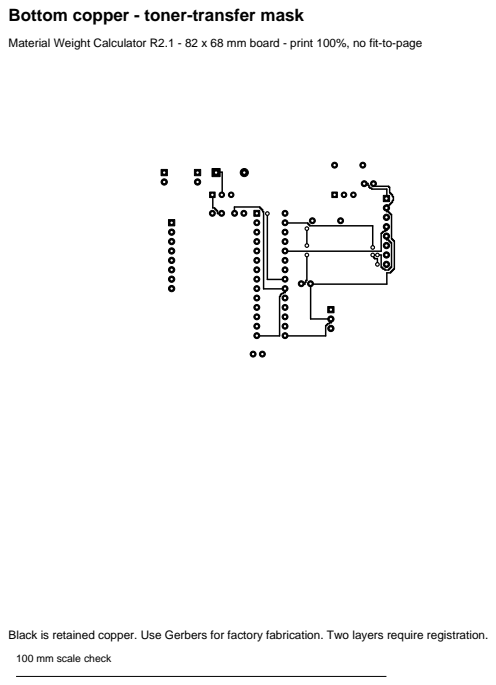
[picture p33: page 4]

Material Weight Calculator R2.1 - 82 x 68 mm board - print 100%, no fit-to-page

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
