myk410/Material-Weight-Calculator/hardware/docs/display_adapter_copper_1to1.pdf

## Display adapter: Top copper - component-side reference

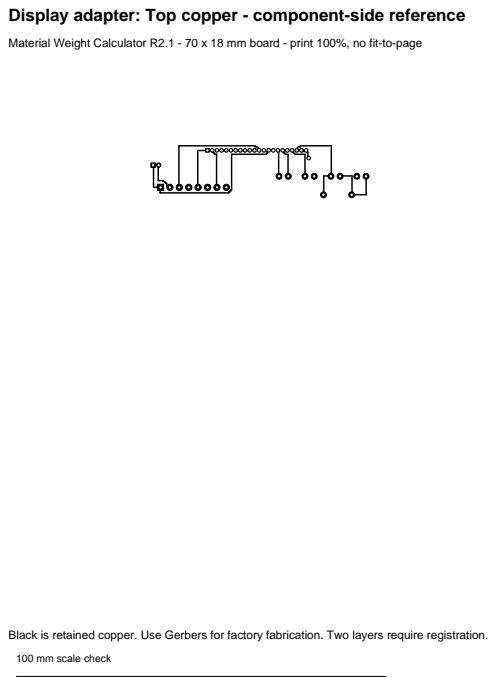
[picture p34: page 1]

Material Weight Calculator R2.1 - 70 x 18 mm board - print 100%, no fit-to-page

Black is retained copper. Use Gerbers for factory fabrication. Two layers require registration.
100 mm scale check

## Display adapter: Top copper - MIRRORED toner-transfer mask

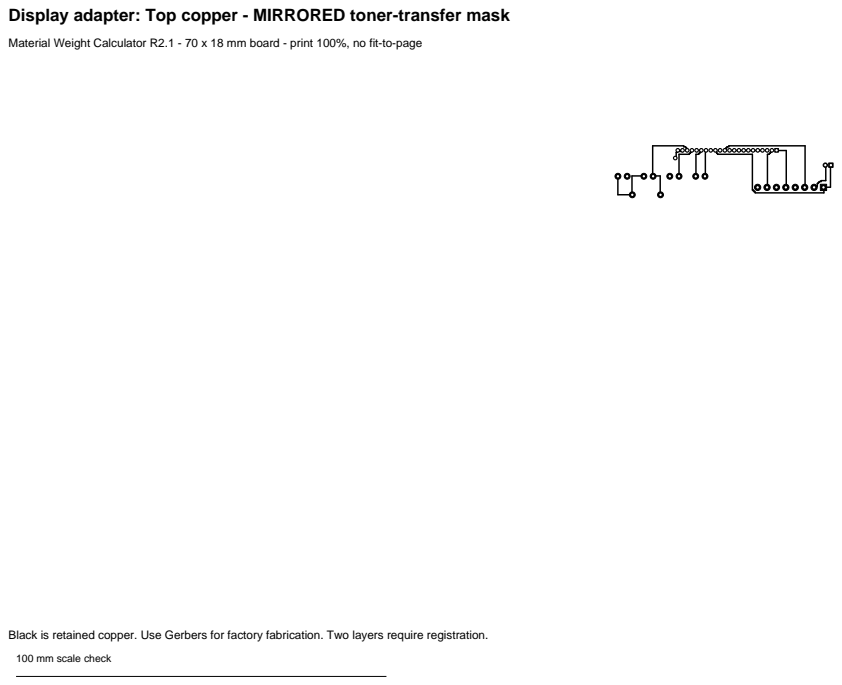
[picture p35: page 2]

Material Weight Calculator R2.1 - 70 x 18 mm board - print 100%, no fit-to-page

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

## Display adapter: Bottom copper - viewed from underside

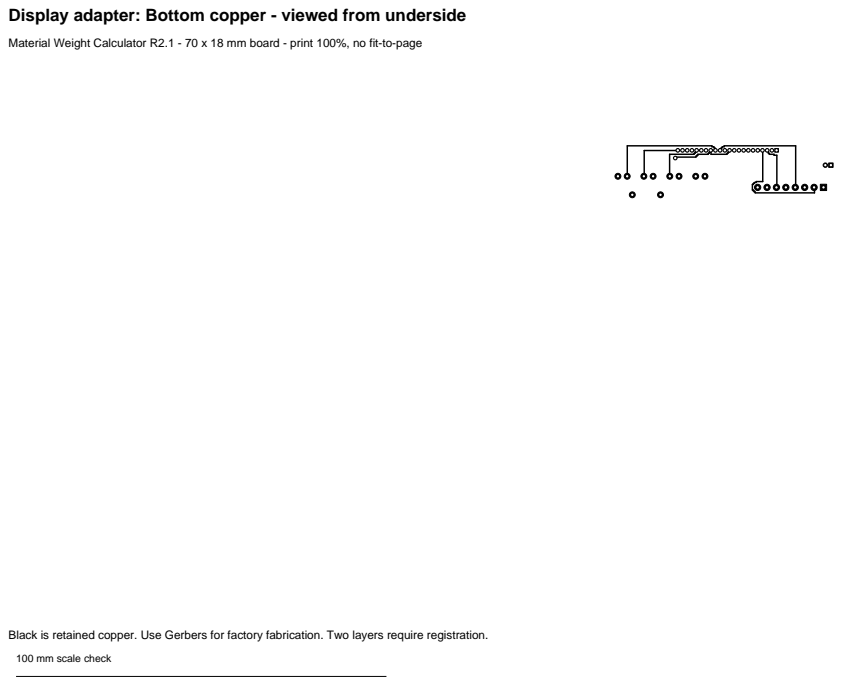
[picture p36: page 3]

Material Weight Calculator R2.1 - 70 x 18 mm board - print 100%, no fit-to-page

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

## Display adapter: Bottom copper - toner-transfer mask

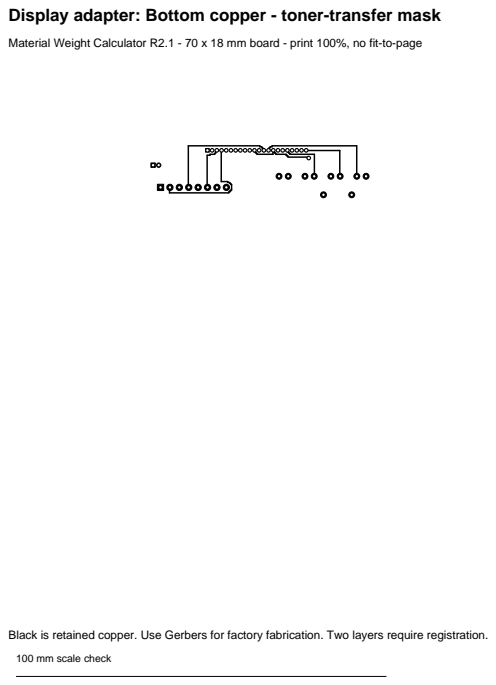
[picture p37: page 4]

Material Weight Calculator R2.1 - 70 x 18 mm board - print 100%, no fit-to-page

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
