myk410/Material-Weight-Calculator/hardware/docs/display_adapter_schematic.pdf

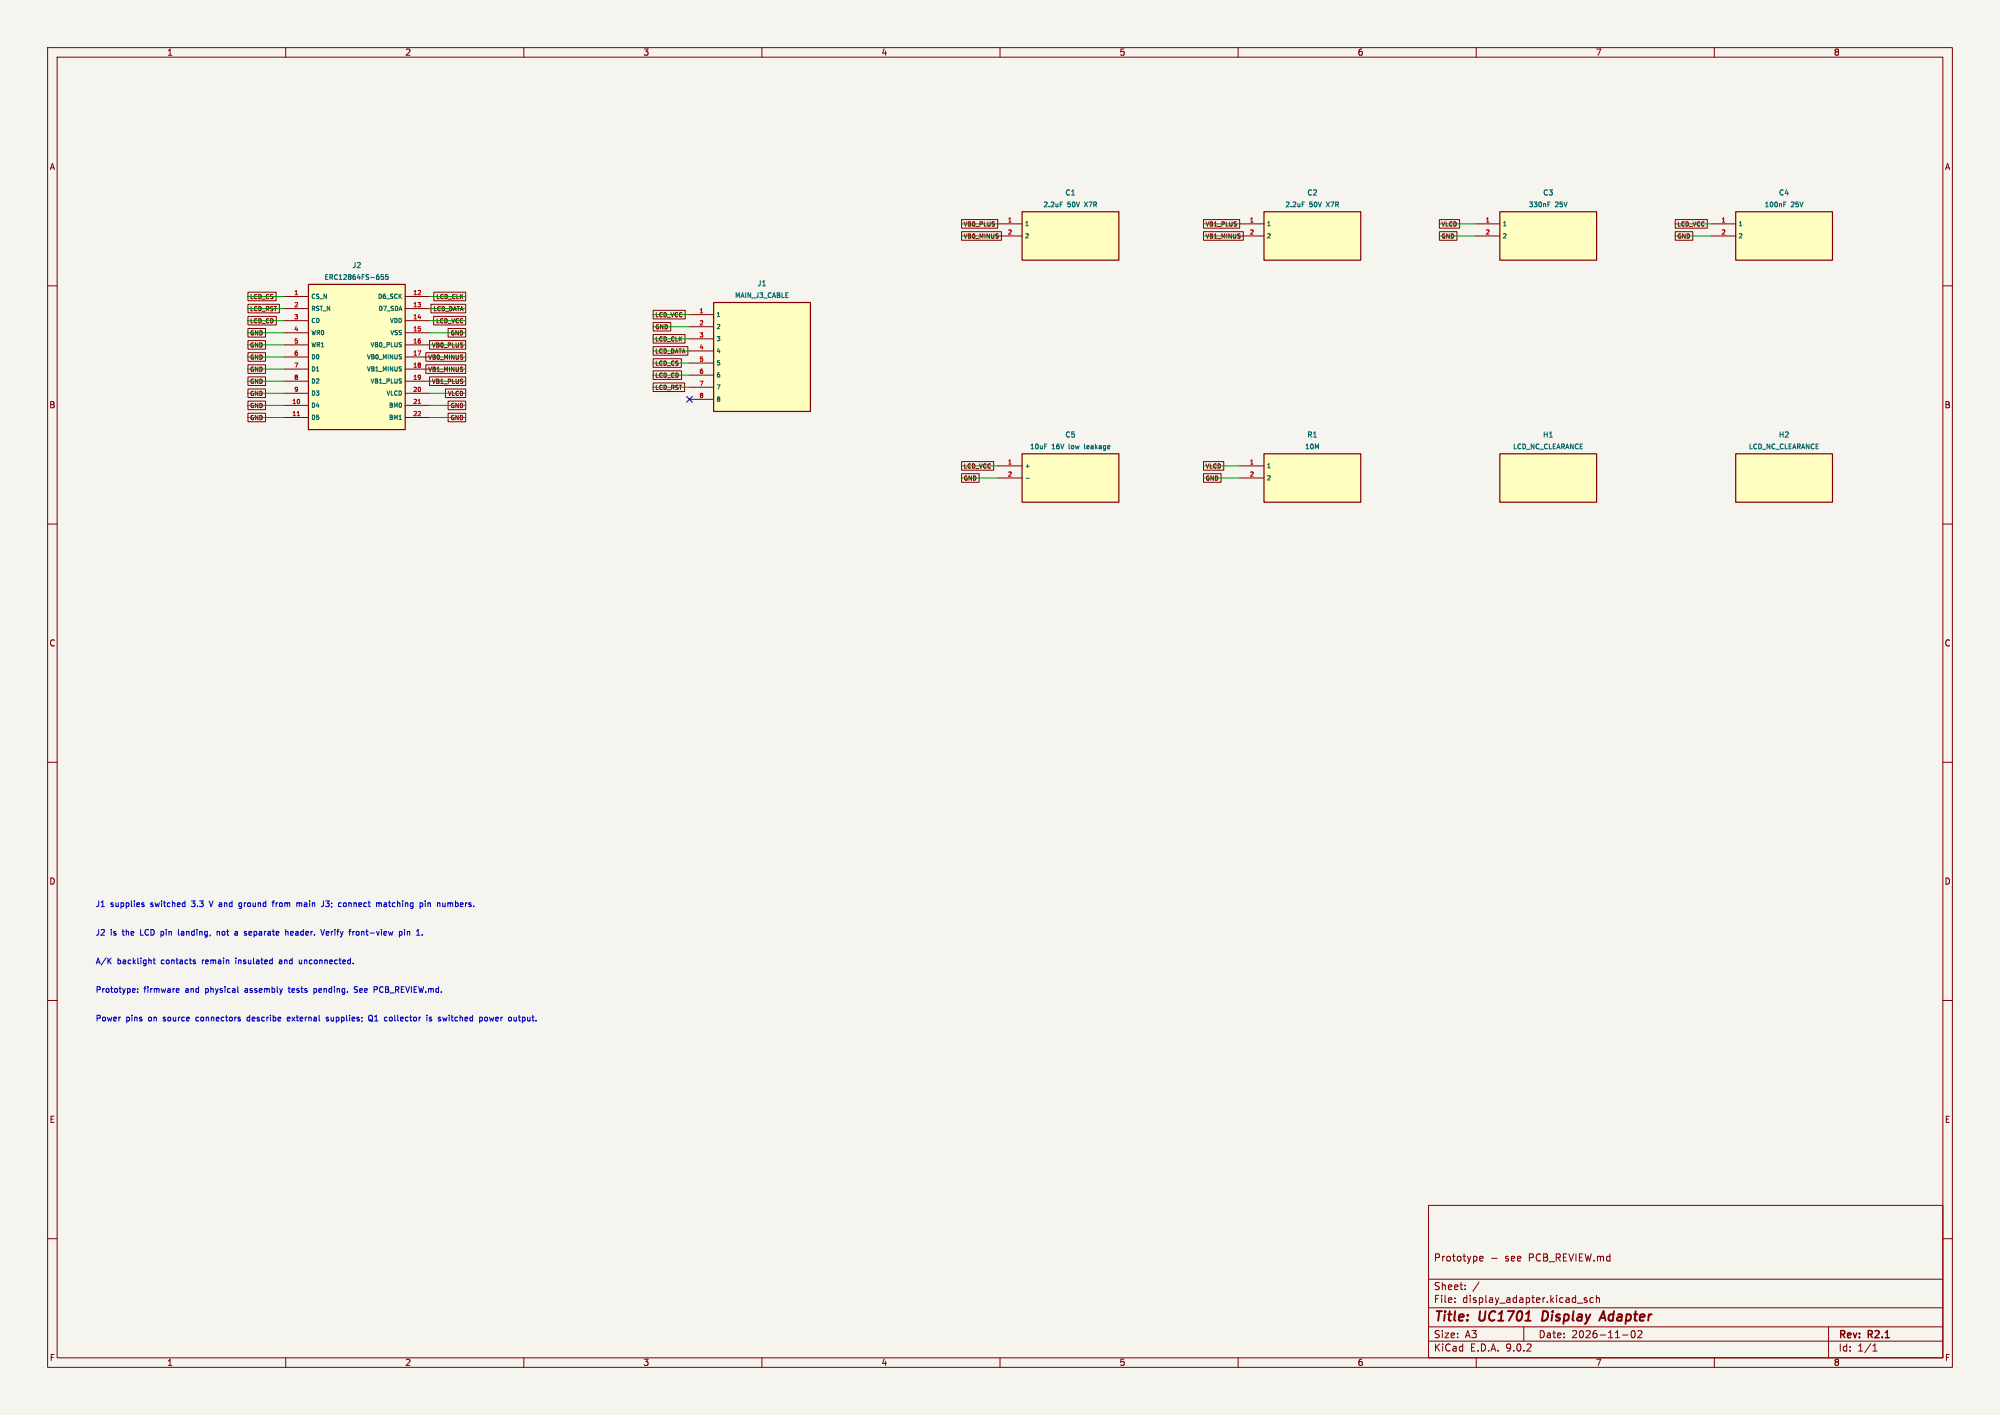
[picture p38: page 1]

LCD_CLK GND GND GND GND GND
