myk410/Material-Weight-Calculator/hardware/docs/display_adapter_drill.pdf

# Display adapter drill template

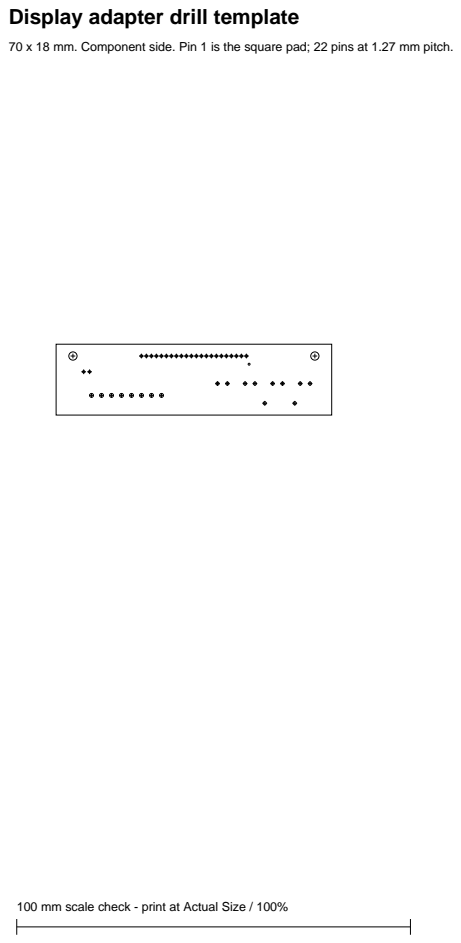
[picture p39: page 1]

70 x 18 mm. Component side. Pin 1 is the square pad; 22 pins at 1.27 mm pitch.

100 mm scale check - print at Actual Size / 100%
