myk410/Material-Weight-Calculator/hardware/docs/drill_template.pdf

## PCB drill and outline template

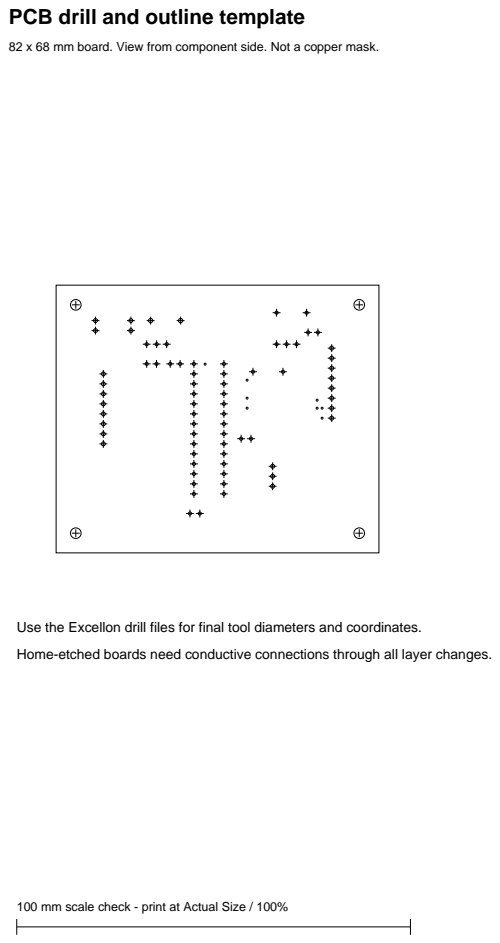
[picture p40: page 1]

82 x 68 mm board. View from component side. Not a copper mask.

Use the Excellon drill files for final tool diameters and coordinates.
Home-etched boards need conductive connections through all layer changes.

100 mm scale check - print at Actual Size / 100%
