myk410/Material-Weight-Calculator/hardware/docs/keypad_fit_template.pdf

# Keypad alignment check - actual scale

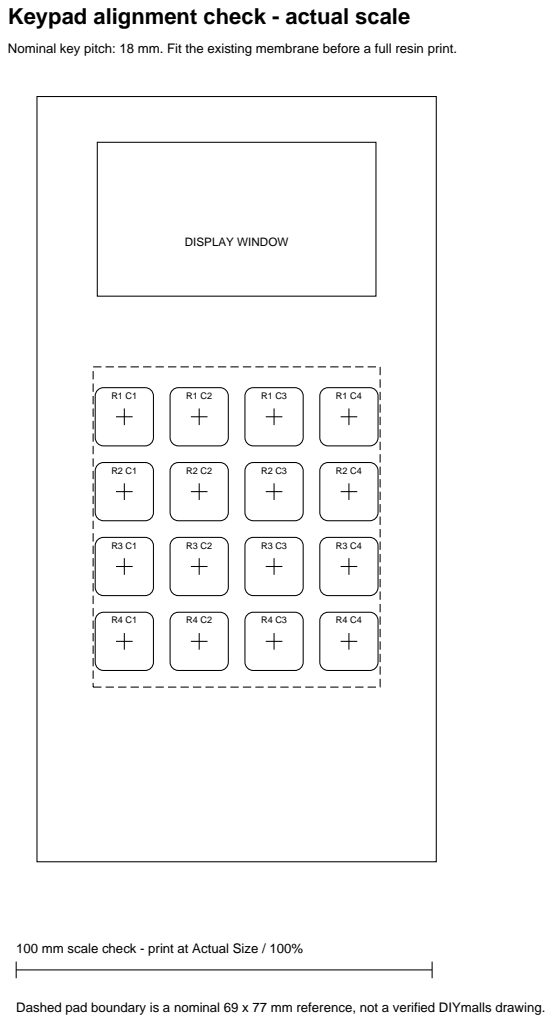
[picture p41: page 1]

Nominal key pitch: 18 mm. Fit the existing membrane before a full resin print.

100 mm scale check - print at Actual Size / 100%

Dashed pad boundary is a nominal 69 x 77 mm reference, not a verified DIYmalls drawing.
