myk410/Material-Weight-Calculator/hardware/docs/schematic.pdf

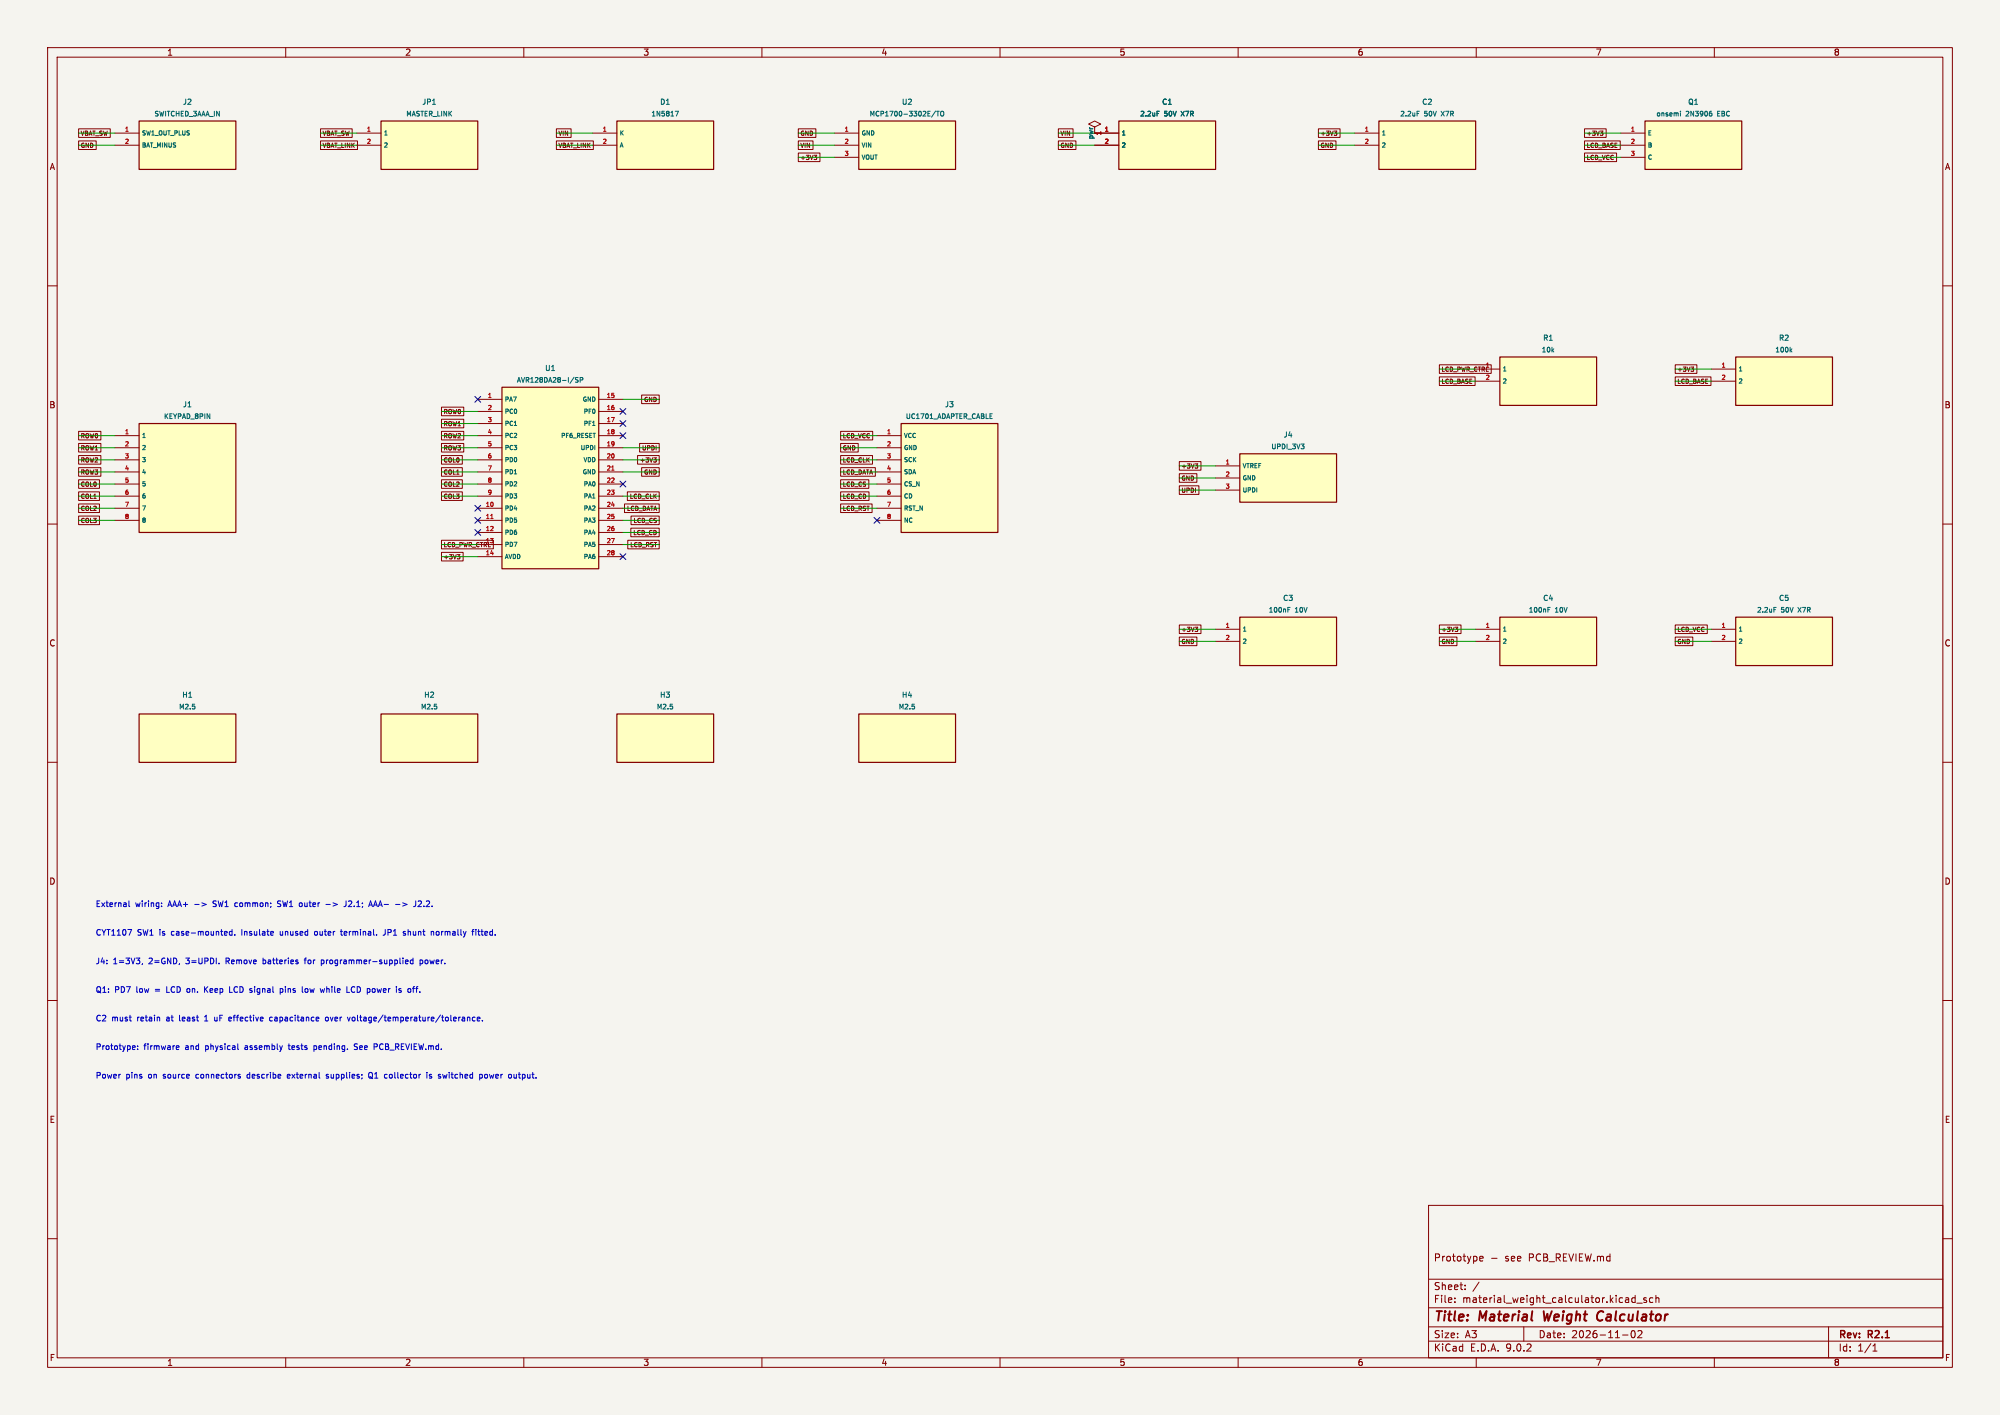
[picture p42: page 1]
