myk410/Material-Weight-Calculator/hardware/docs/r3/adapter_schematic.pdf

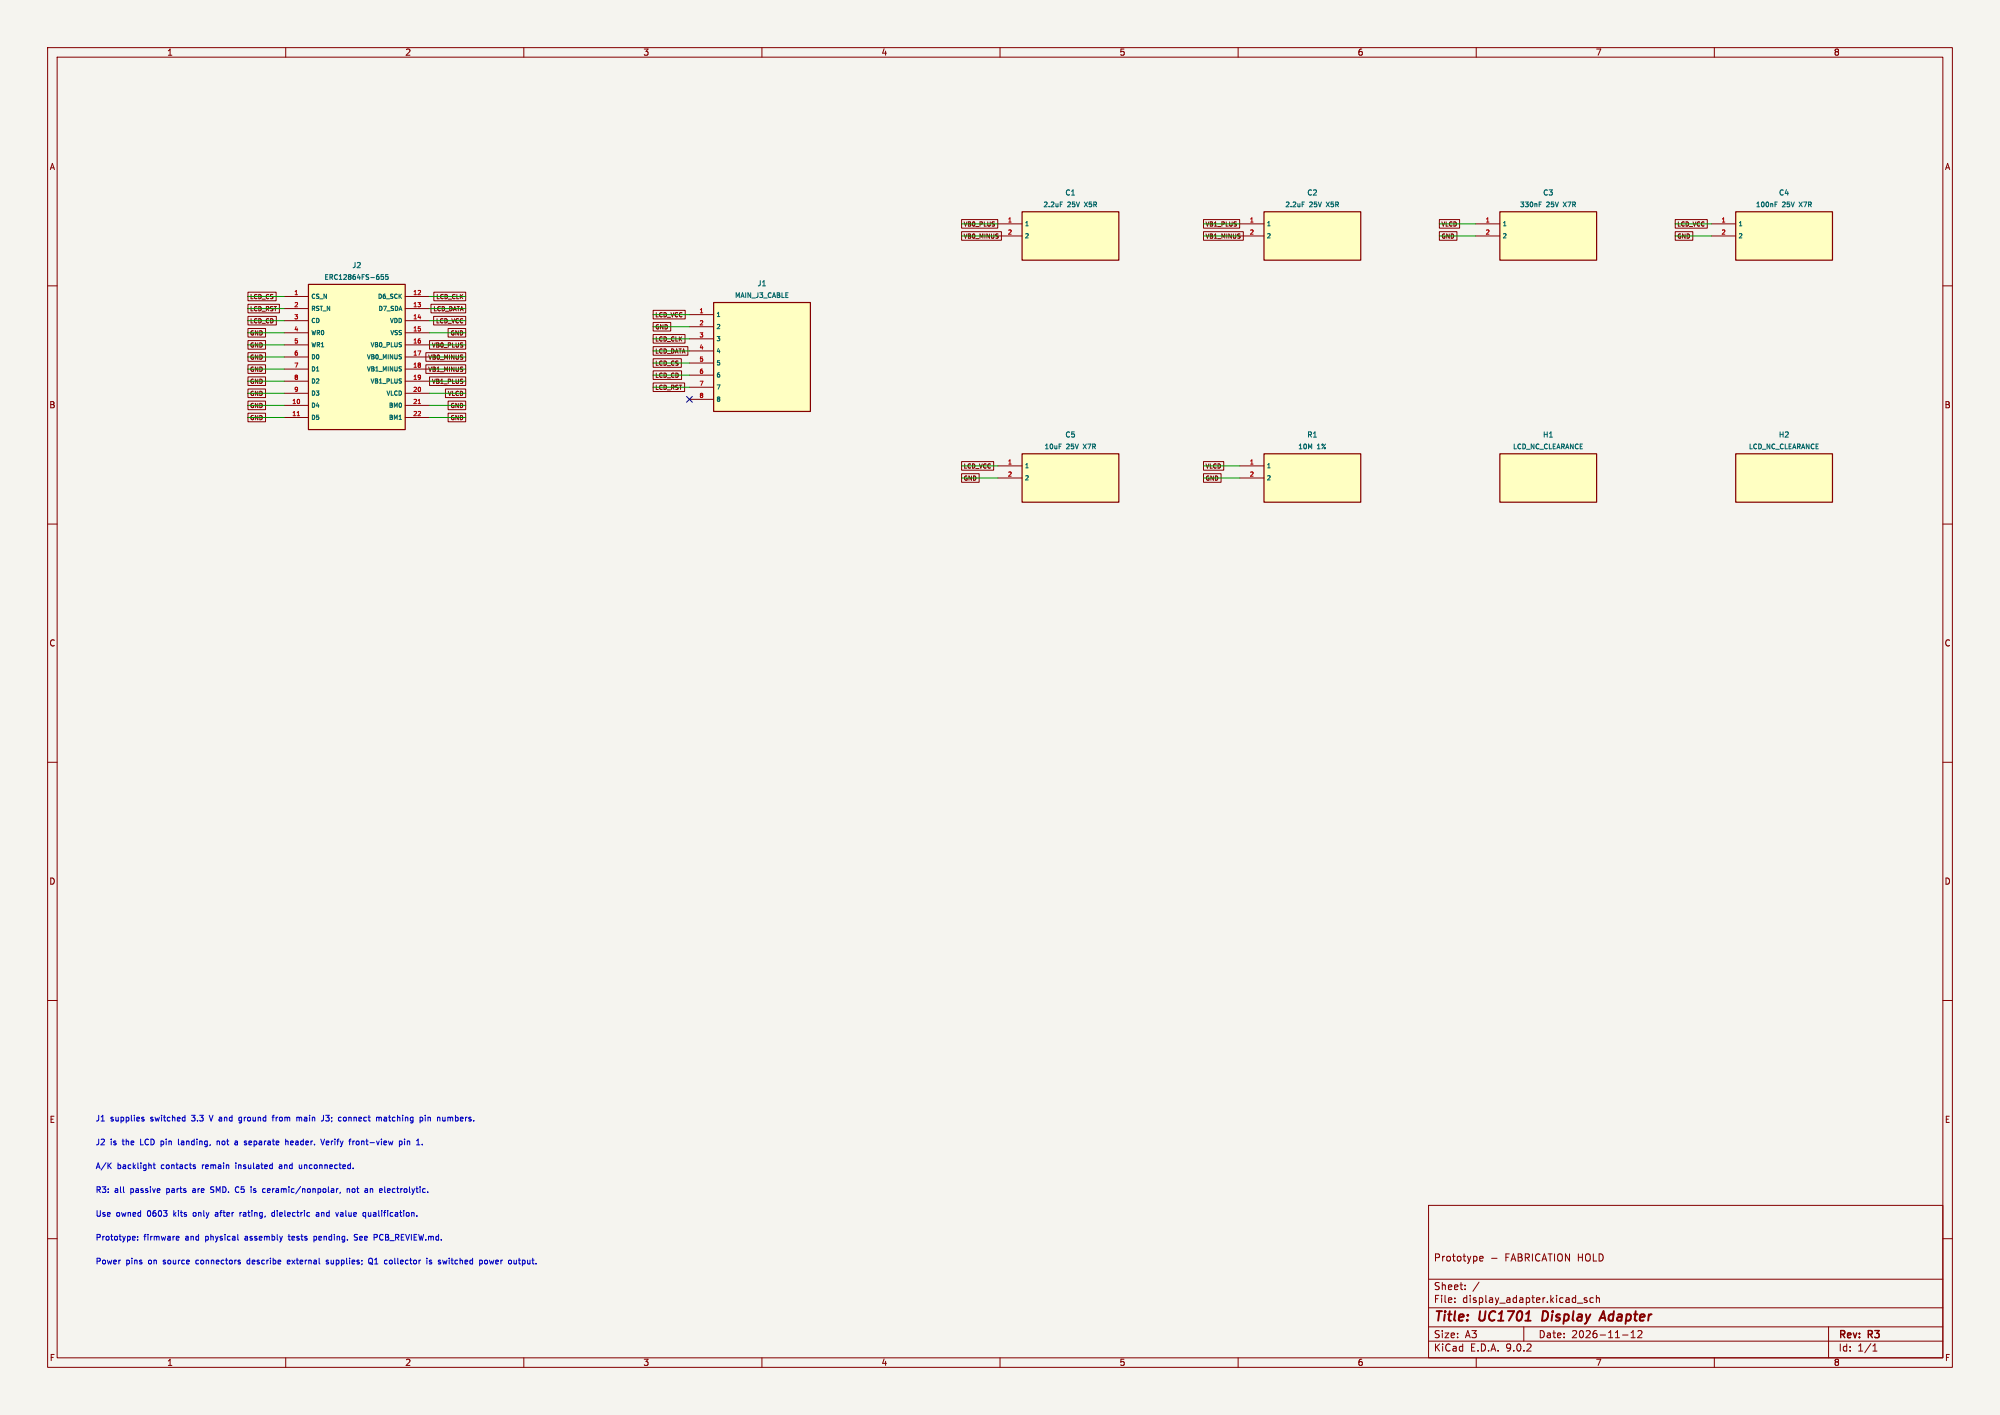
[picture p43: page 1]
