myk410/Material-Weight-Calculator/hardware/docs/r3/main_schematic.pdf

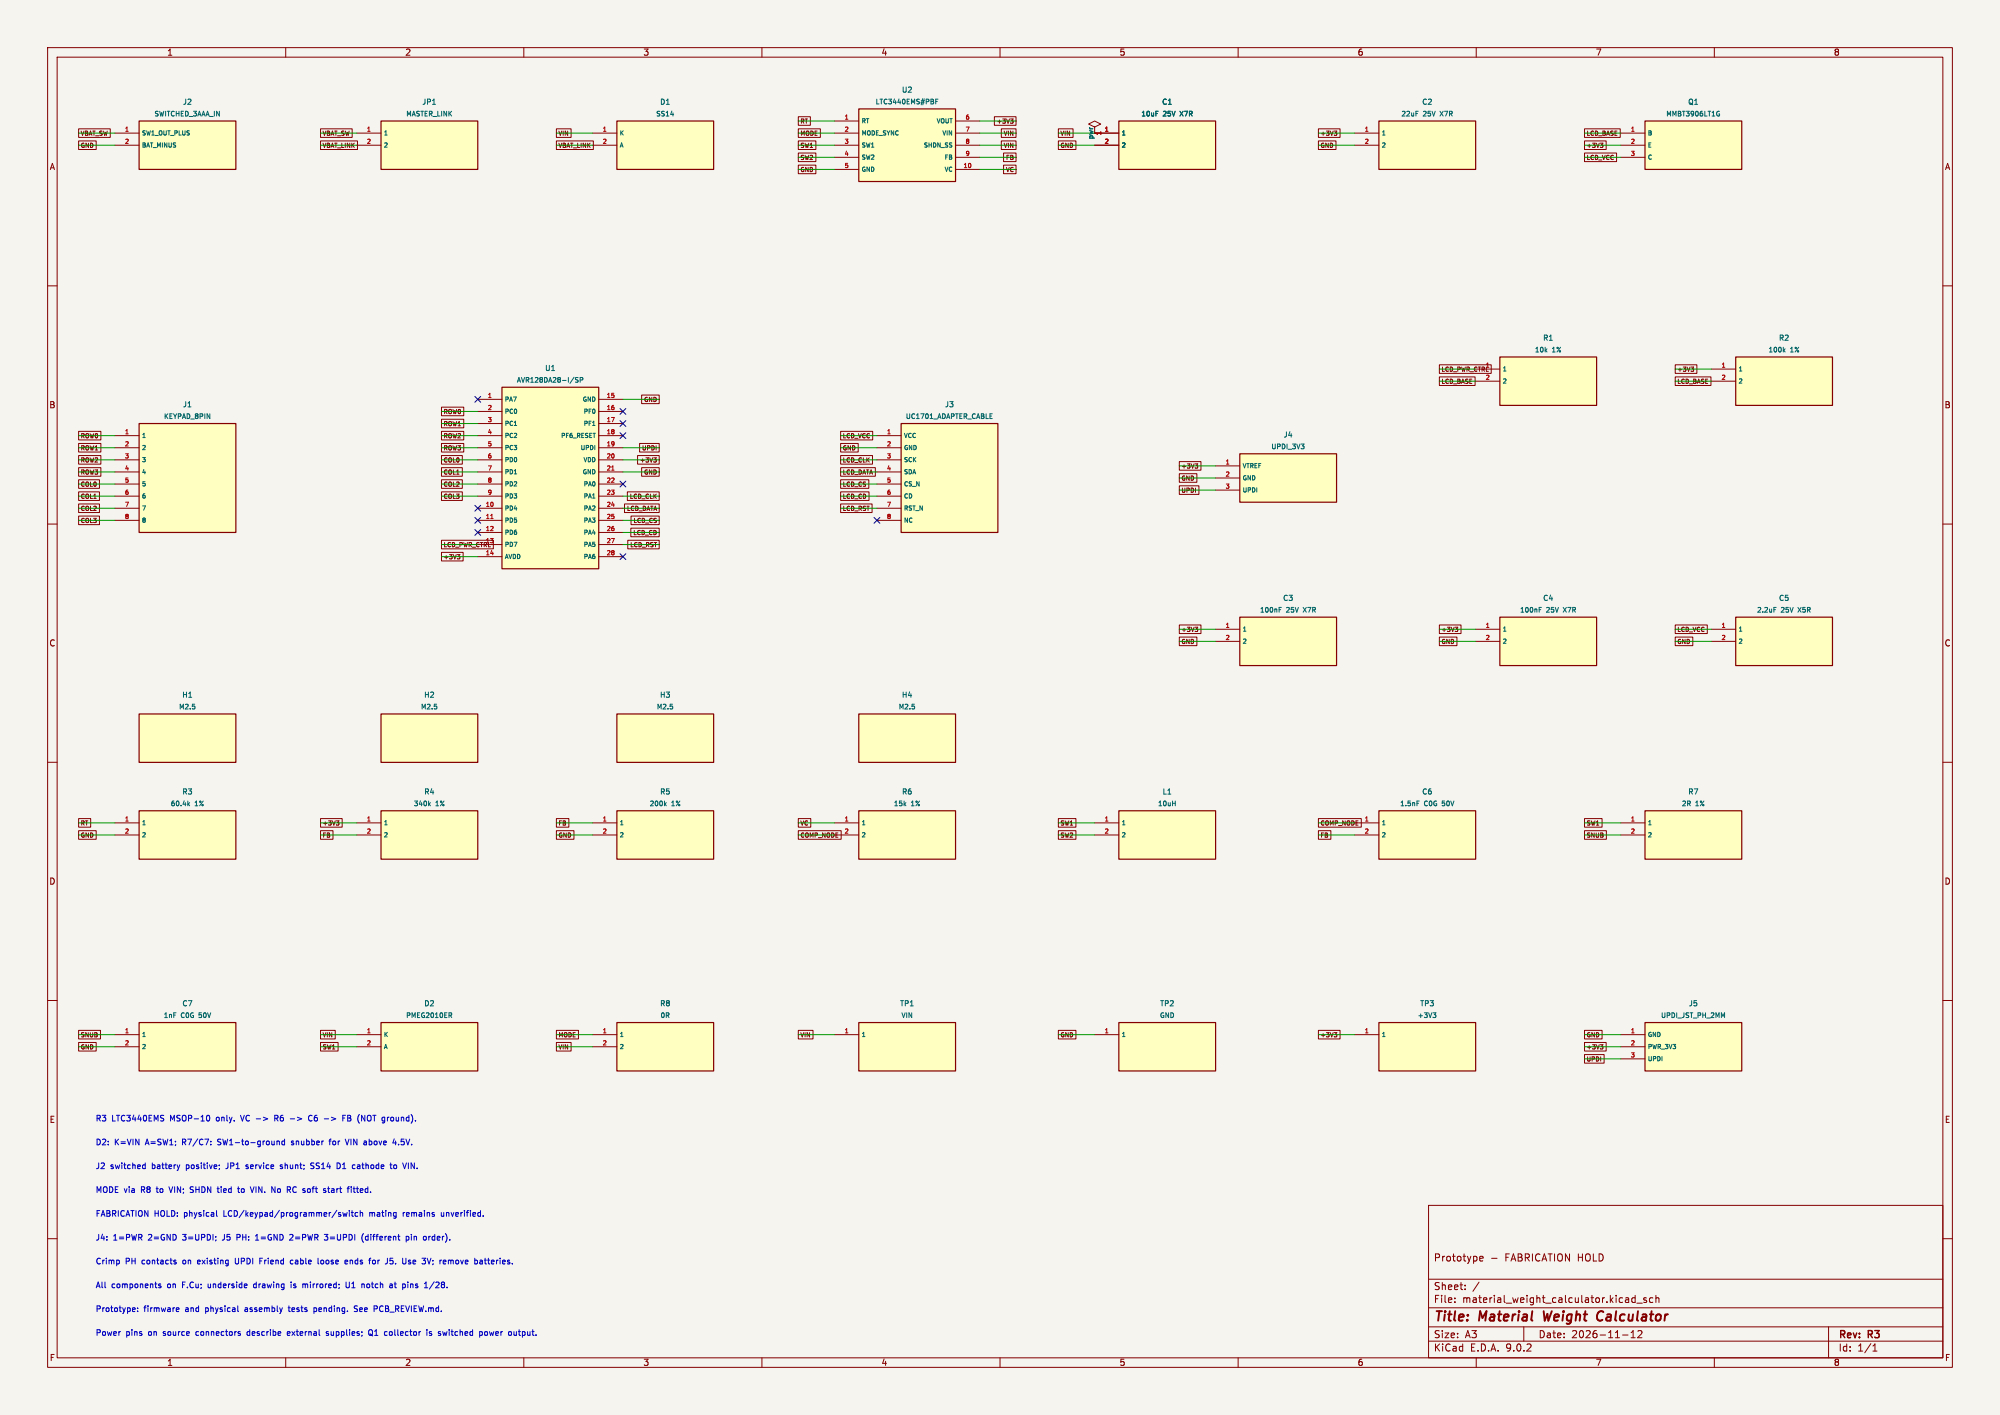
[picture p44: page 1]
