myk410/Material-Weight-Calculator/(list of files, drawings)

Other design files:
hardware/validation/pcb_audit.json
hardware/validation/schematic_net_check.json
