myk410/Material-Weight-Calculator/hardware/pcb/r3/material_weight_calculator.kicad_pcb

## KiCad design hardware/pcb/r3/material_weight_calculator.kicad_pcb (2026-11-12)

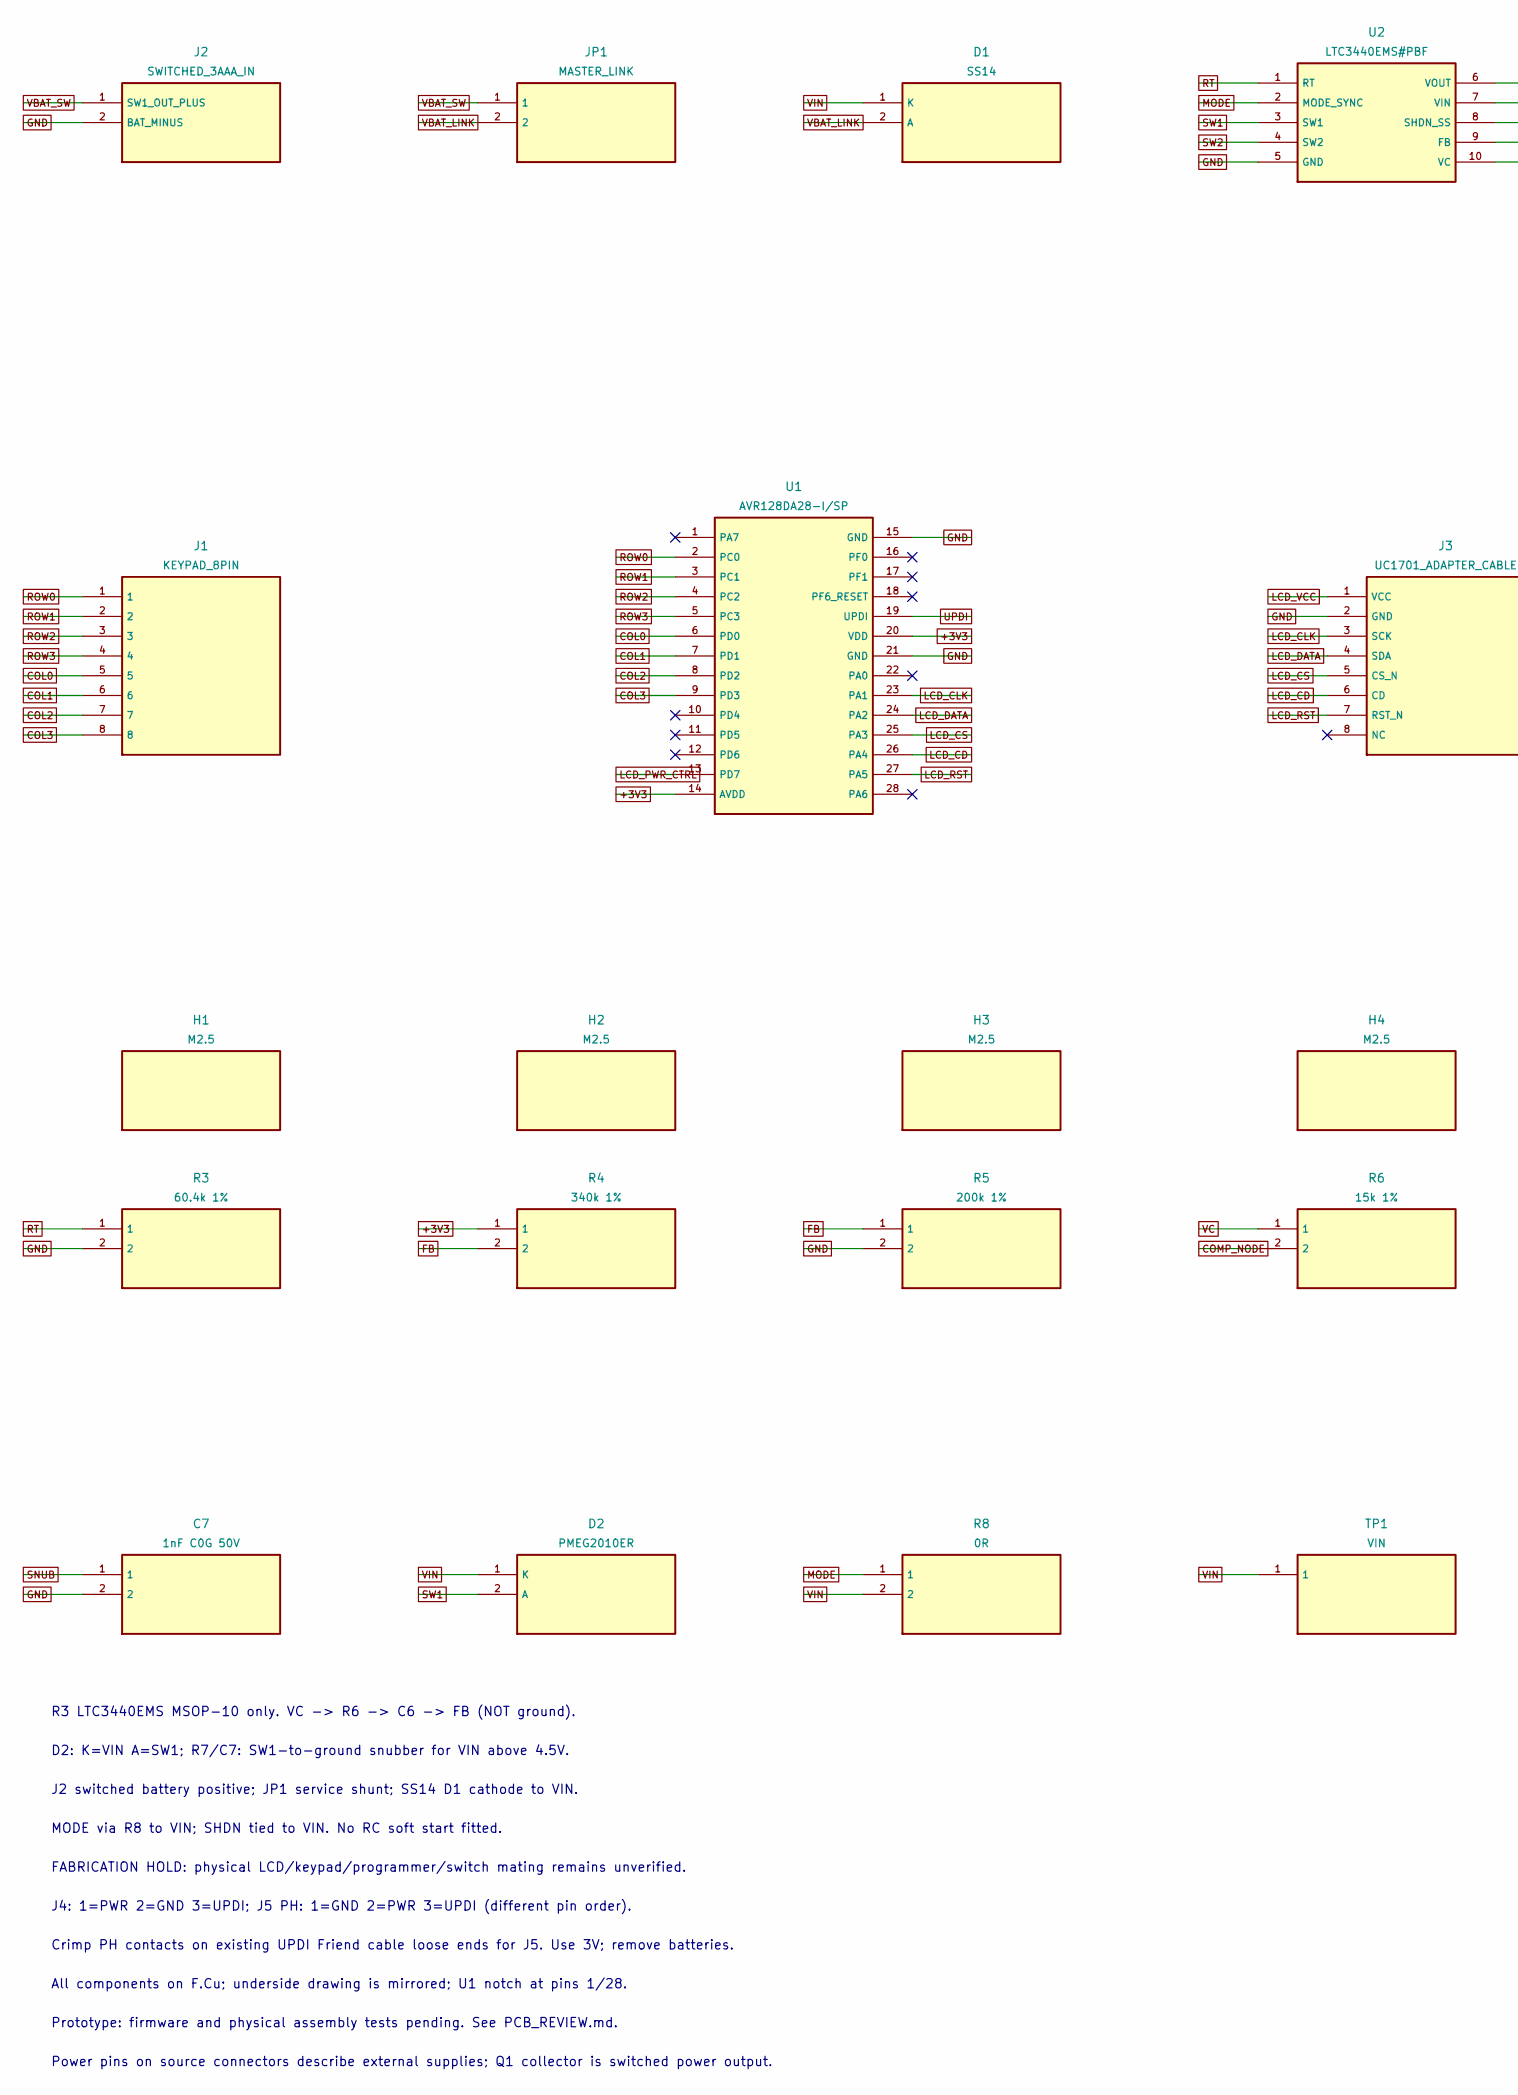
[picture p45: schematic material_weight_calculator.kicad_sch, Material Weight Calculator, part in row 1, column 1]

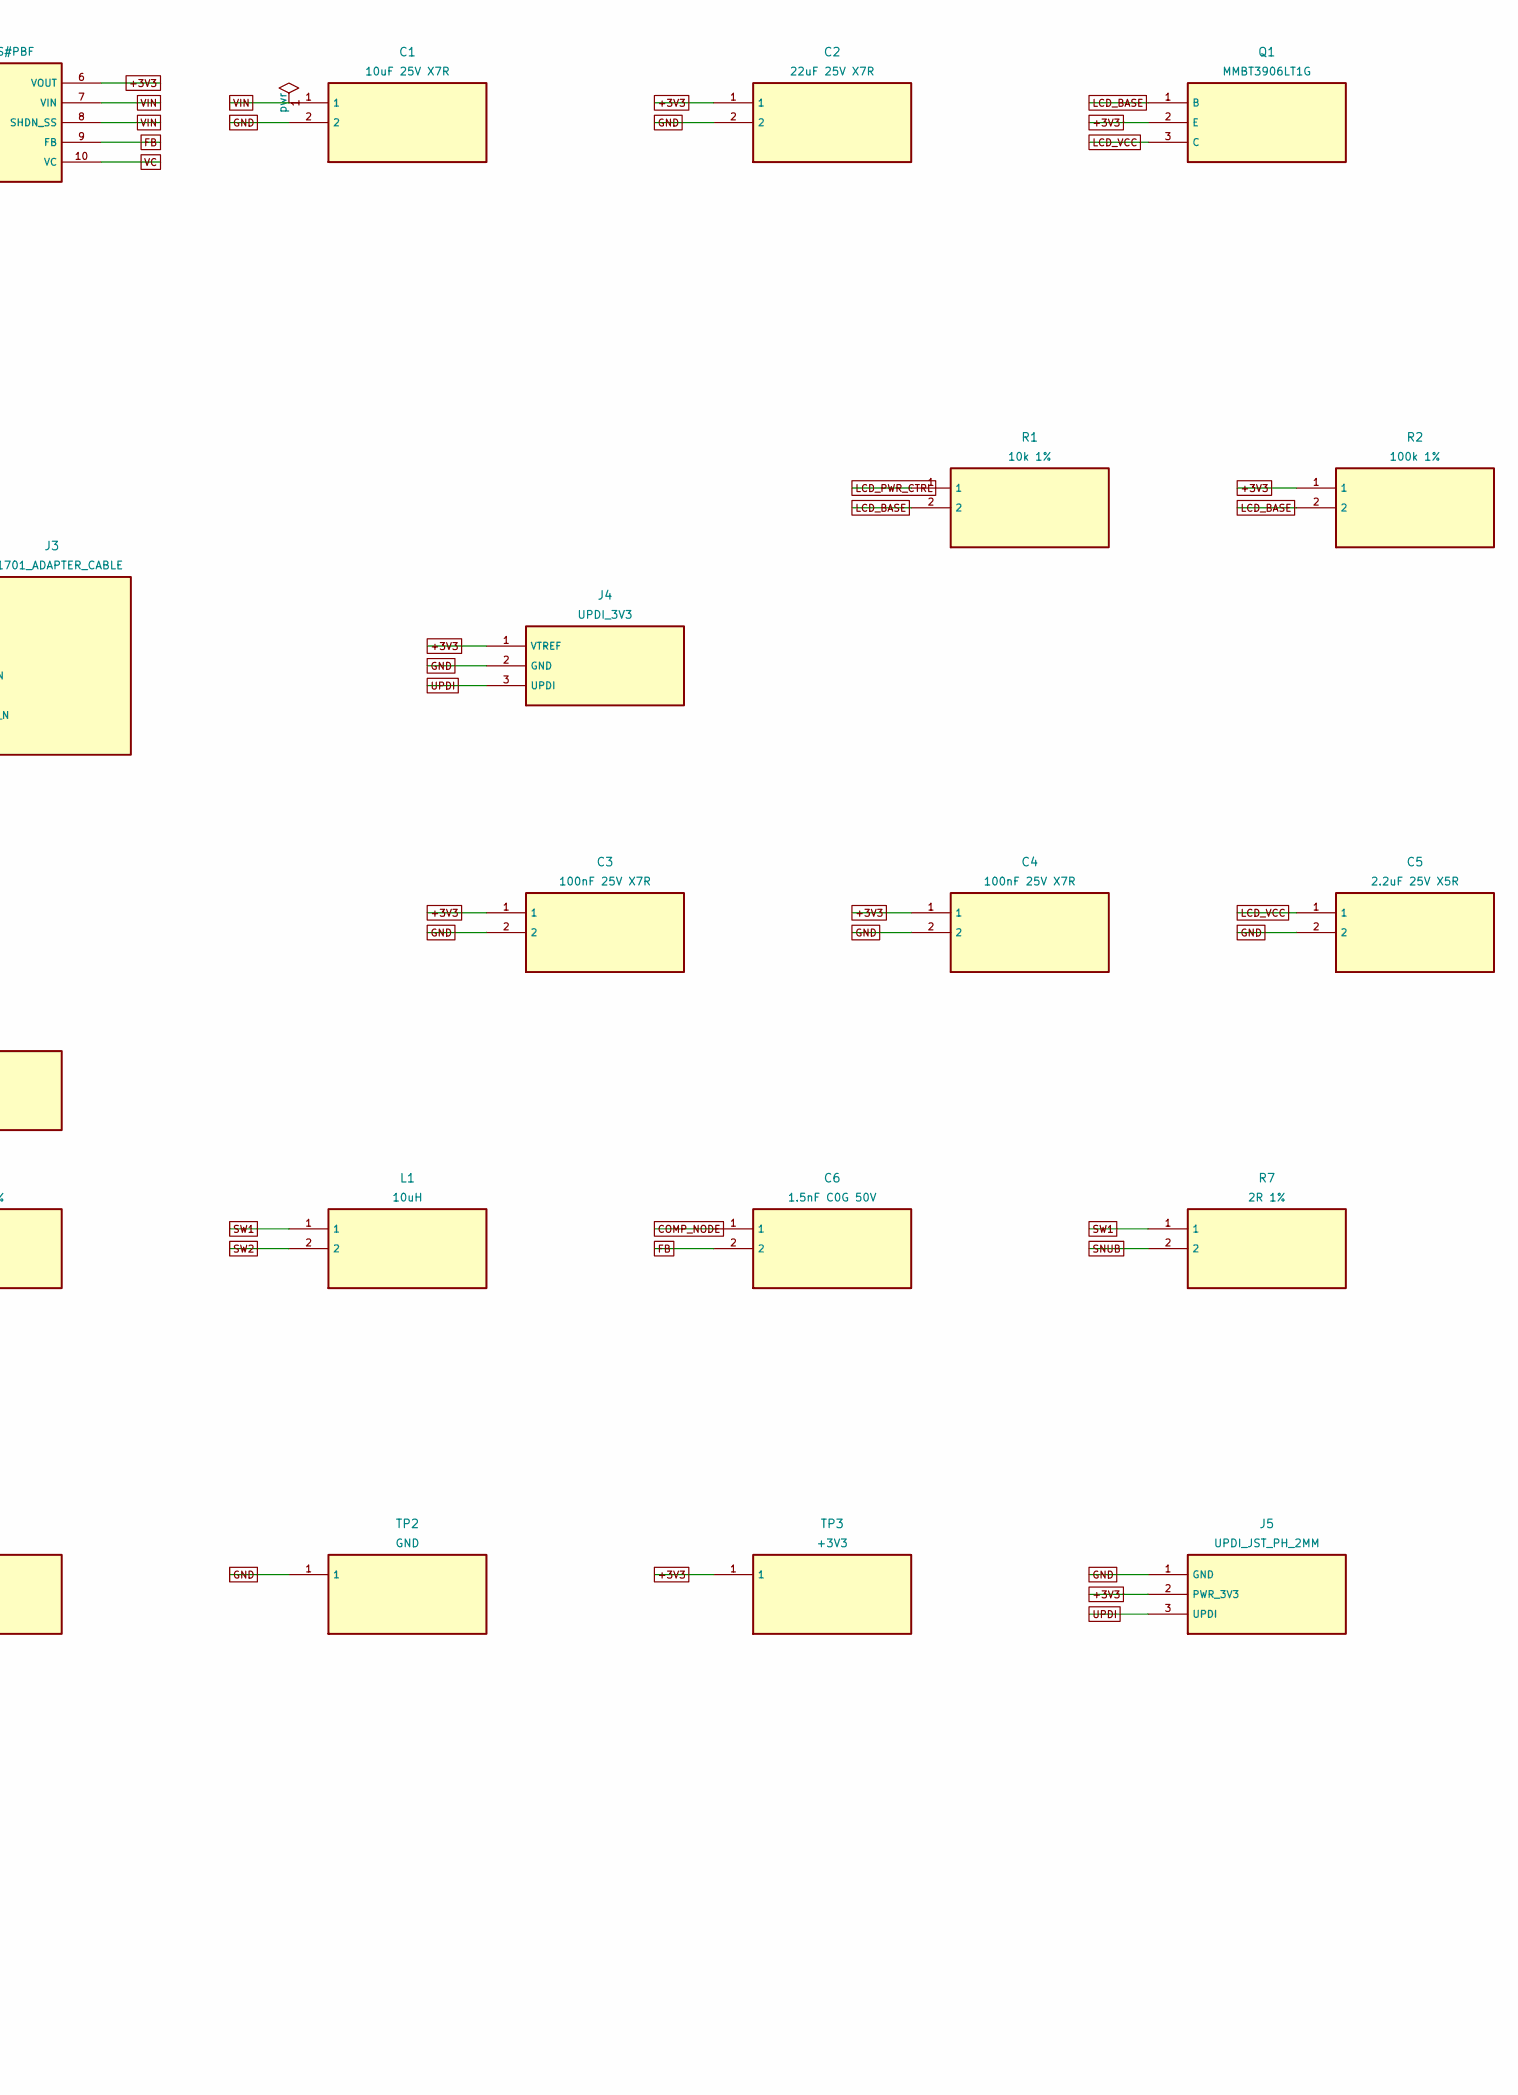
[picture p46: schematic material_weight_calculator.kicad_sch, Material Weight Calculator, part in row 1, column 2]

Parts:
C1: 10uF 25V X7R; C_1206_3216Metric_Pad1.33x1.80mm_HandSolder
C2: 22uF 25V X7R; C_1210_3225Metric_Pad1.33x2.70mm_HandSolder
C3, C4: 100nF 25V X7R; C_0603_1608Metric_Pad1.08x0.95mm_HandSolder
C5: 2.2uF 25V X5R; C_0603_1608Metric_Pad1.08x0.95mm_HandSolder
C6: 1.5nF C0G 50V; C_0805_2012Metric_Pad1.18x1.45mm_HandSolder
C7: 1nF C0G 50V; C_0805_2012Metric_Pad1.18x1.45mm_HandSolder
D1: SS14; D_SMA
D2: PMEG2010ER; Nexperia_CFP3_SOD-123W
H1, H2, H3, H4: M2.5; MountingHole_2.7mm_M2.5
J1: KEYPAD_8PIN; PinHeader_1x08_P2.54mm_Vertical
J2: SWITCHED_3AAA_IN; PinHeader_1x02_P2.54mm_Vertical
J3: UC1701_ADAPTER_CABLE; PinHeader_1x08_P2.54mm_Vertical
J4: UPDI_3V3; PinHeader_1x03_P2.54mm_Vertical
J5: UPDI_JST_PH_2MM; JST_PH_B3B-PH-K_1x03_P2.00mm_Vertical
JP1: MASTER_LINK; PinHeader_1x02_P2.54mm_Vertical
L1: 10uH; L_CDRH6D38_HandSolder
Q1: MMBT3906LT1G; SOT-23_Handsoldering
R1: 10k 1%; R_0603_1608Metric_Pad0.98x0.95mm_HandSolder
R2: 100k 1%; R_0603_1608Metric_Pad0.98x0.95mm_HandSolder
R3: 60.4k 1%; R_0805_2012Metric_Pad1.20x1.40mm_HandSolder
R4: 340k 1%; R_0805_2012Metric_Pad1.20x1.40mm_HandSolder
R5: 200k 1%; R_0805_2012Metric_Pad1.20x1.40mm_HandSolder
R6: 15k 1%; R_0805_2012Metric_Pad1.20x1.40mm_HandSolder
R7: 2R 1%; R_0805_2012Metric_Pad1.20x1.40mm_HandSolder
R8: 0R; R_0805_2012Metric_Pad1.20x1.40mm_HandSolder
TP1: VIN; TestPoint_Pad_D2.0mm
TP2: GND; TestPoint_Pad_D2.0mm
TP3: +3V3; TestPoint_Pad_D2.0mm
U1: AVR128DA28-I/SP; DIP-28_W7.62mm
U2: LTC3440EMS#PBF; MSOP-10_3x3mm_P0.5mm

Connections:
+3V3: C2.1, C3.1, C4.1, J4.1 (VTREF), J5.2 (PWR_3V3), Q1.2 (E), R2.1, R4.1, TP3.1, U1.14 (AVDD), U1.20 (VDD), U2.6 (VOUT)
COL0: J1.5, U1.6 (PD0)
COL1: J1.6, U1.7 (PD1)
COL2: J1.7, U1.8 (PD2)
COL3: J1.8, U1.9 (PD3)
COMP_NODE: C6.1, R6.2
FB: C6.2, R4.2, R5.1, U2.9 (FB)
GND: C1.2, C2.2, C3.2, C4.2, C5.2, C7.2, J2.2 (BAT_MINUS), J3.2 (GND), J4.2 (GND), J5.1 (GND), R3.2, R5.2, TP2.1, U1.15 (GND), U1.21 (GND), U2.5 (GND)
LCD_BASE: Q1.1 (B), R1.2, R2.2
LCD_CD: J3.6 (CD), U1.26 (PA4)
LCD_CLK: J3.3 (SCK), U1.23 (PA1)
LCD_CS: J3.5 (CS_N), U1.25 (PA3)
LCD_DATA: J3.4 (SDA), U1.24 (PA2)
LCD_PWR_CTRL: R1.1, U1.13 (PD7)
LCD_RST: J3.7 (RST_N), U1.27 (PA5)
LCD_VCC: C5.1, J3.1 (VCC), Q1.3 (C)
MODE: R8.1, U2.2 (MODE_SYNC)
ROW0: J1.1, U1.2 (PC0)
ROW1: J1.2, U1.3 (PC1)
ROW2: J1.3, U1.4 (PC2)
ROW3: J1.4, U1.5 (PC3)
RT: R3.1, U2.1 (RT)
SNUB: C7.1, R7.2
SW1: D2.2 (A), L1.1, R7.1, U2.3 (SW1)
SW2: L1.2, U2.4 (SW2)
UPDI: J4.3 (UPDI), J5.3 (UPDI), U1.19 (UPDI)
VBAT_LINK: D1.2 (A), JP1.2
VBAT_SW: J2.1 (SW1_OUT_PLUS), JP1.1
VC: R6.1, U2.10 (VC)
VIN: C1.1, D1.1 (K), D2.1 (K), R8.2, TP1.1, U2.7 (VIN), U2.8 (SHDN_SS)

Notes on the sheet:
R3 LTC3440EMS MSOP-10 only. VC -> R6 -> C6 -> FB (NOT ground).
D2: K=VIN A=SW1; R7/C7: SW1-to-ground snubber for VIN above 4.5V.
J2 switched battery positive; JP1 service shunt; SS14 D1 cathode to VIN.
MODE via R8 to VIN; SHDN tied to VIN. No RC soft start fitted.
FABRICATION HOLD: physical LCD/keypad/programmer/switch mating remains unverified.
J4: 1=PWR 2=GND 3=UPDI; J5 PH: 1=GND 2=PWR 3=UPDI (different pin order).
Crimp PH contacts on existing UPDI Friend cable loose ends for J5. Use 3V; remove batteries.
All components on F.Cu; underside drawing is mirrored; U1 notch at pins 1/28.
Prototype: firmware and physical assembly tests pending. See PCB_REVIEW.md.
Power pins on source connectors describe external supplies; Q1 collector is switched power output.

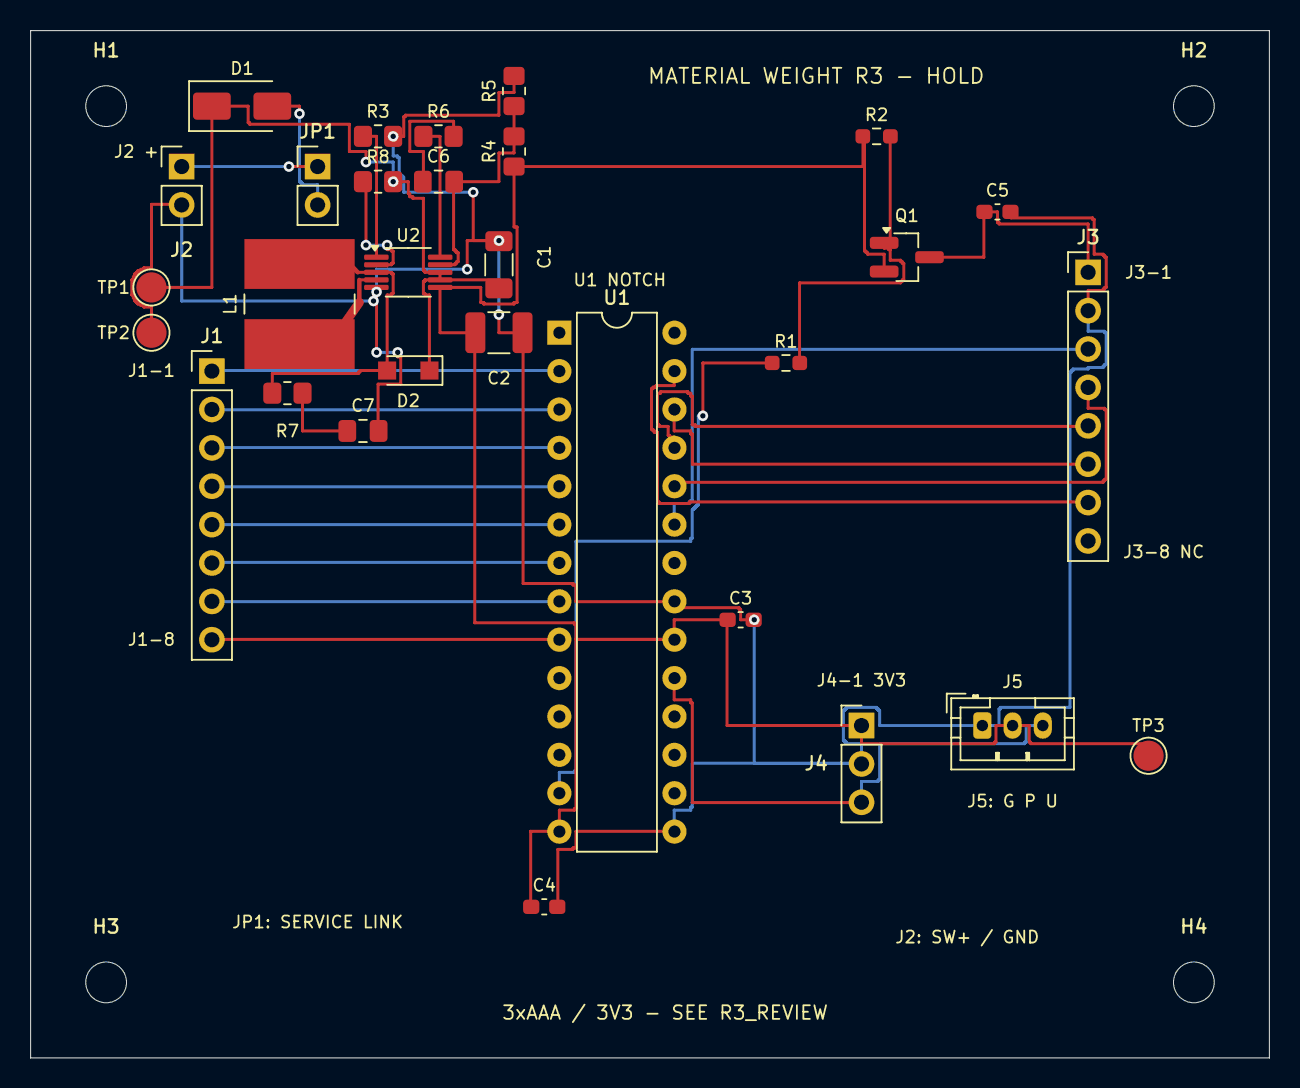
[picture p47: board material_weight_calculator.kicad_pcb from above]

Board: 2 copper layers, 82.0 x 68.0 mm, 34 parts (0 on the bottom side), 30 nets.
