myk410/Material-Weight-Calculator/hardware/pcb/r3/display_adapter/display_adapter.kicad_pcb

## KiCad design hardware/pcb/r3/display_adapter/display_adapter.kicad_pcb (2026-11-12)

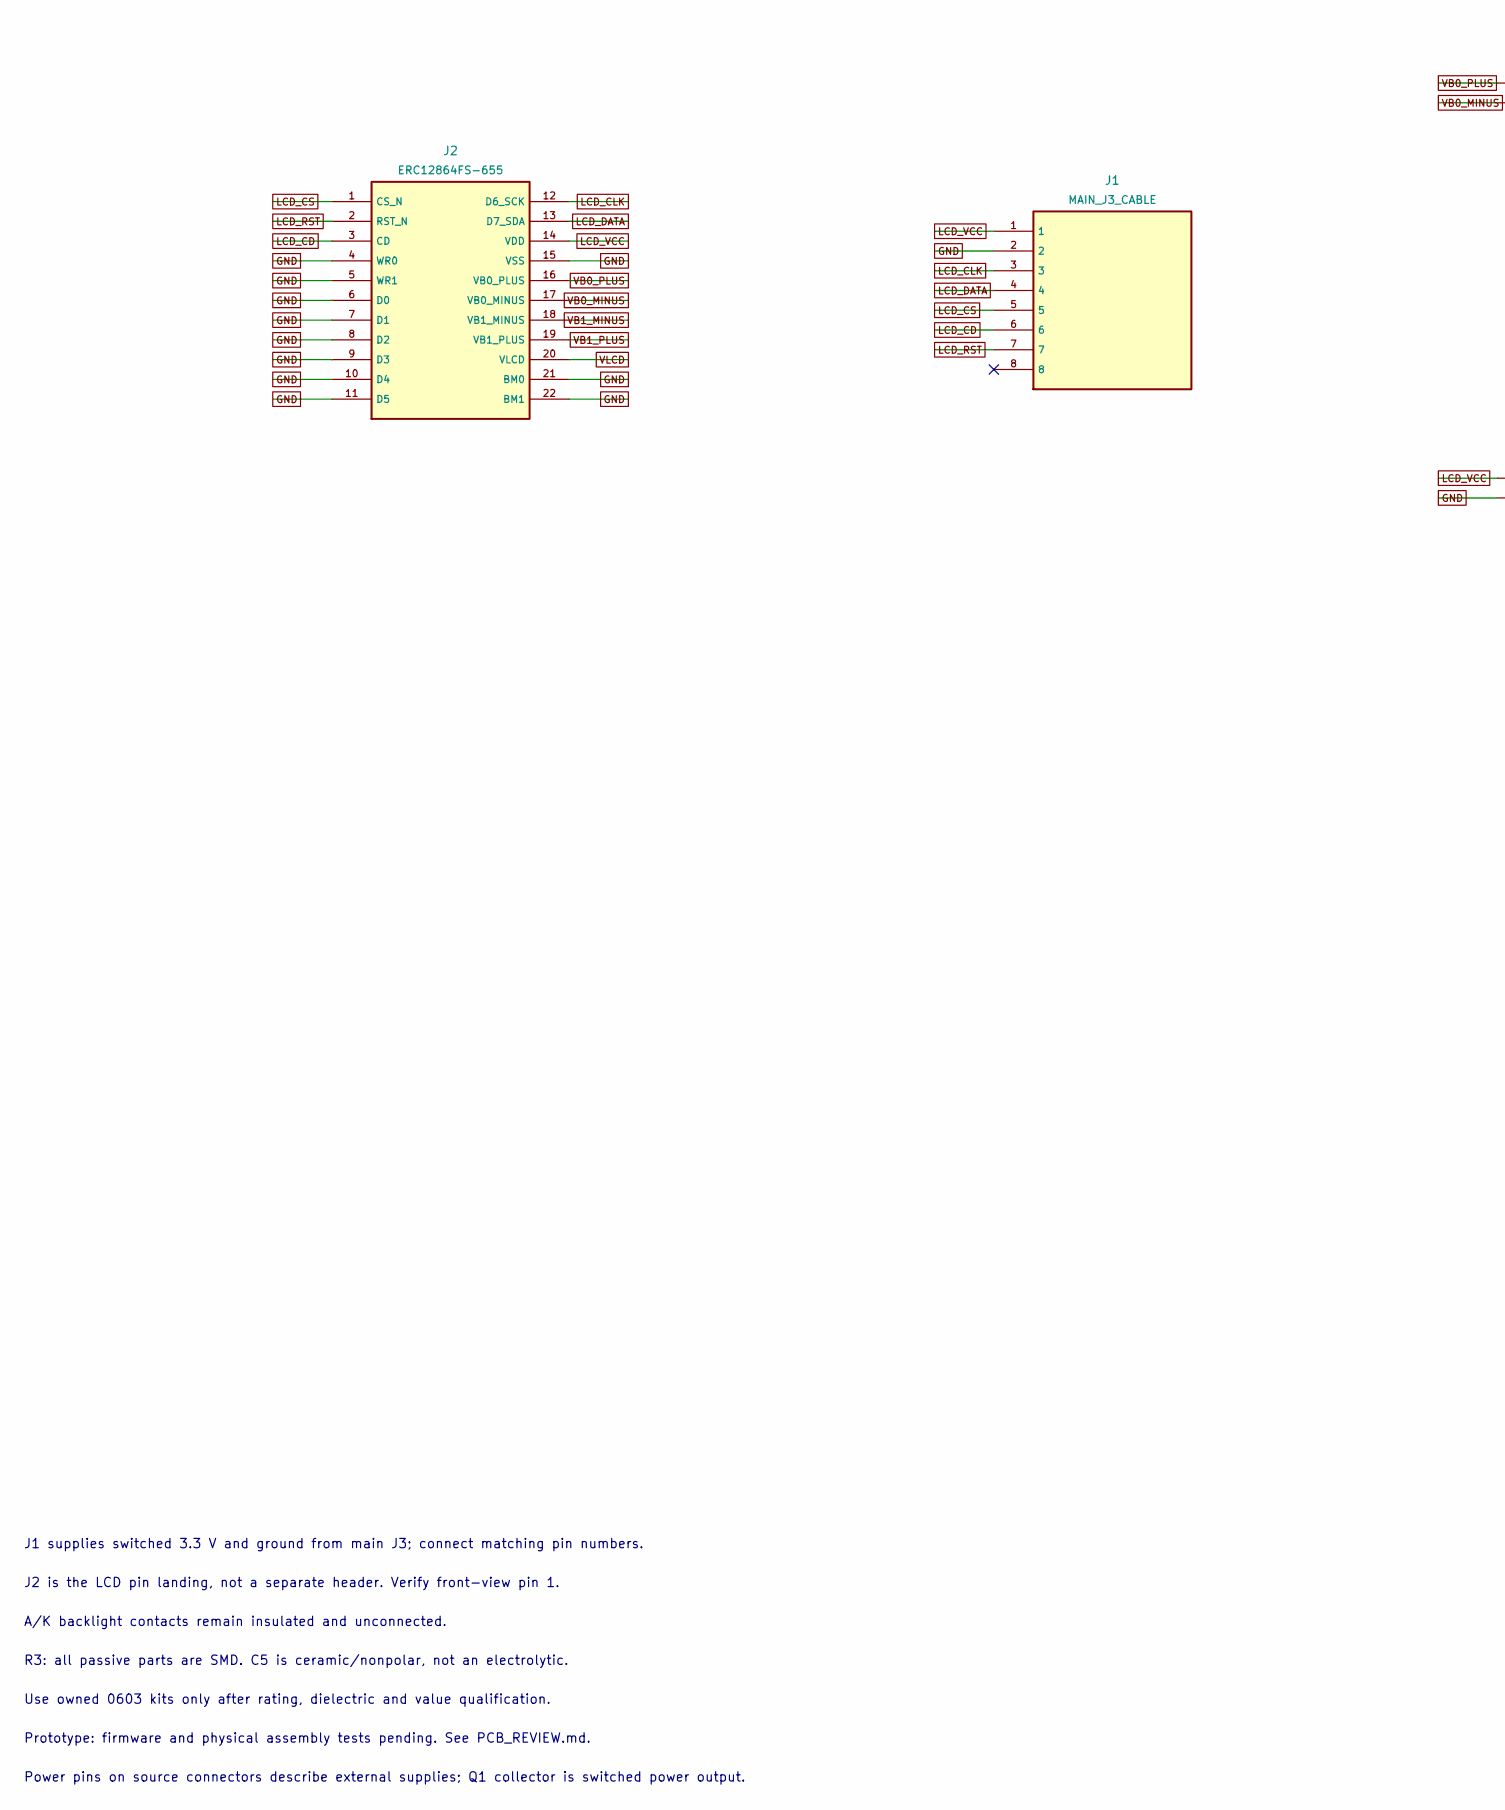
[picture p48: schematic display_adapter.kicad_sch, UC1701 Display Adapter, part in row 1, column 1]

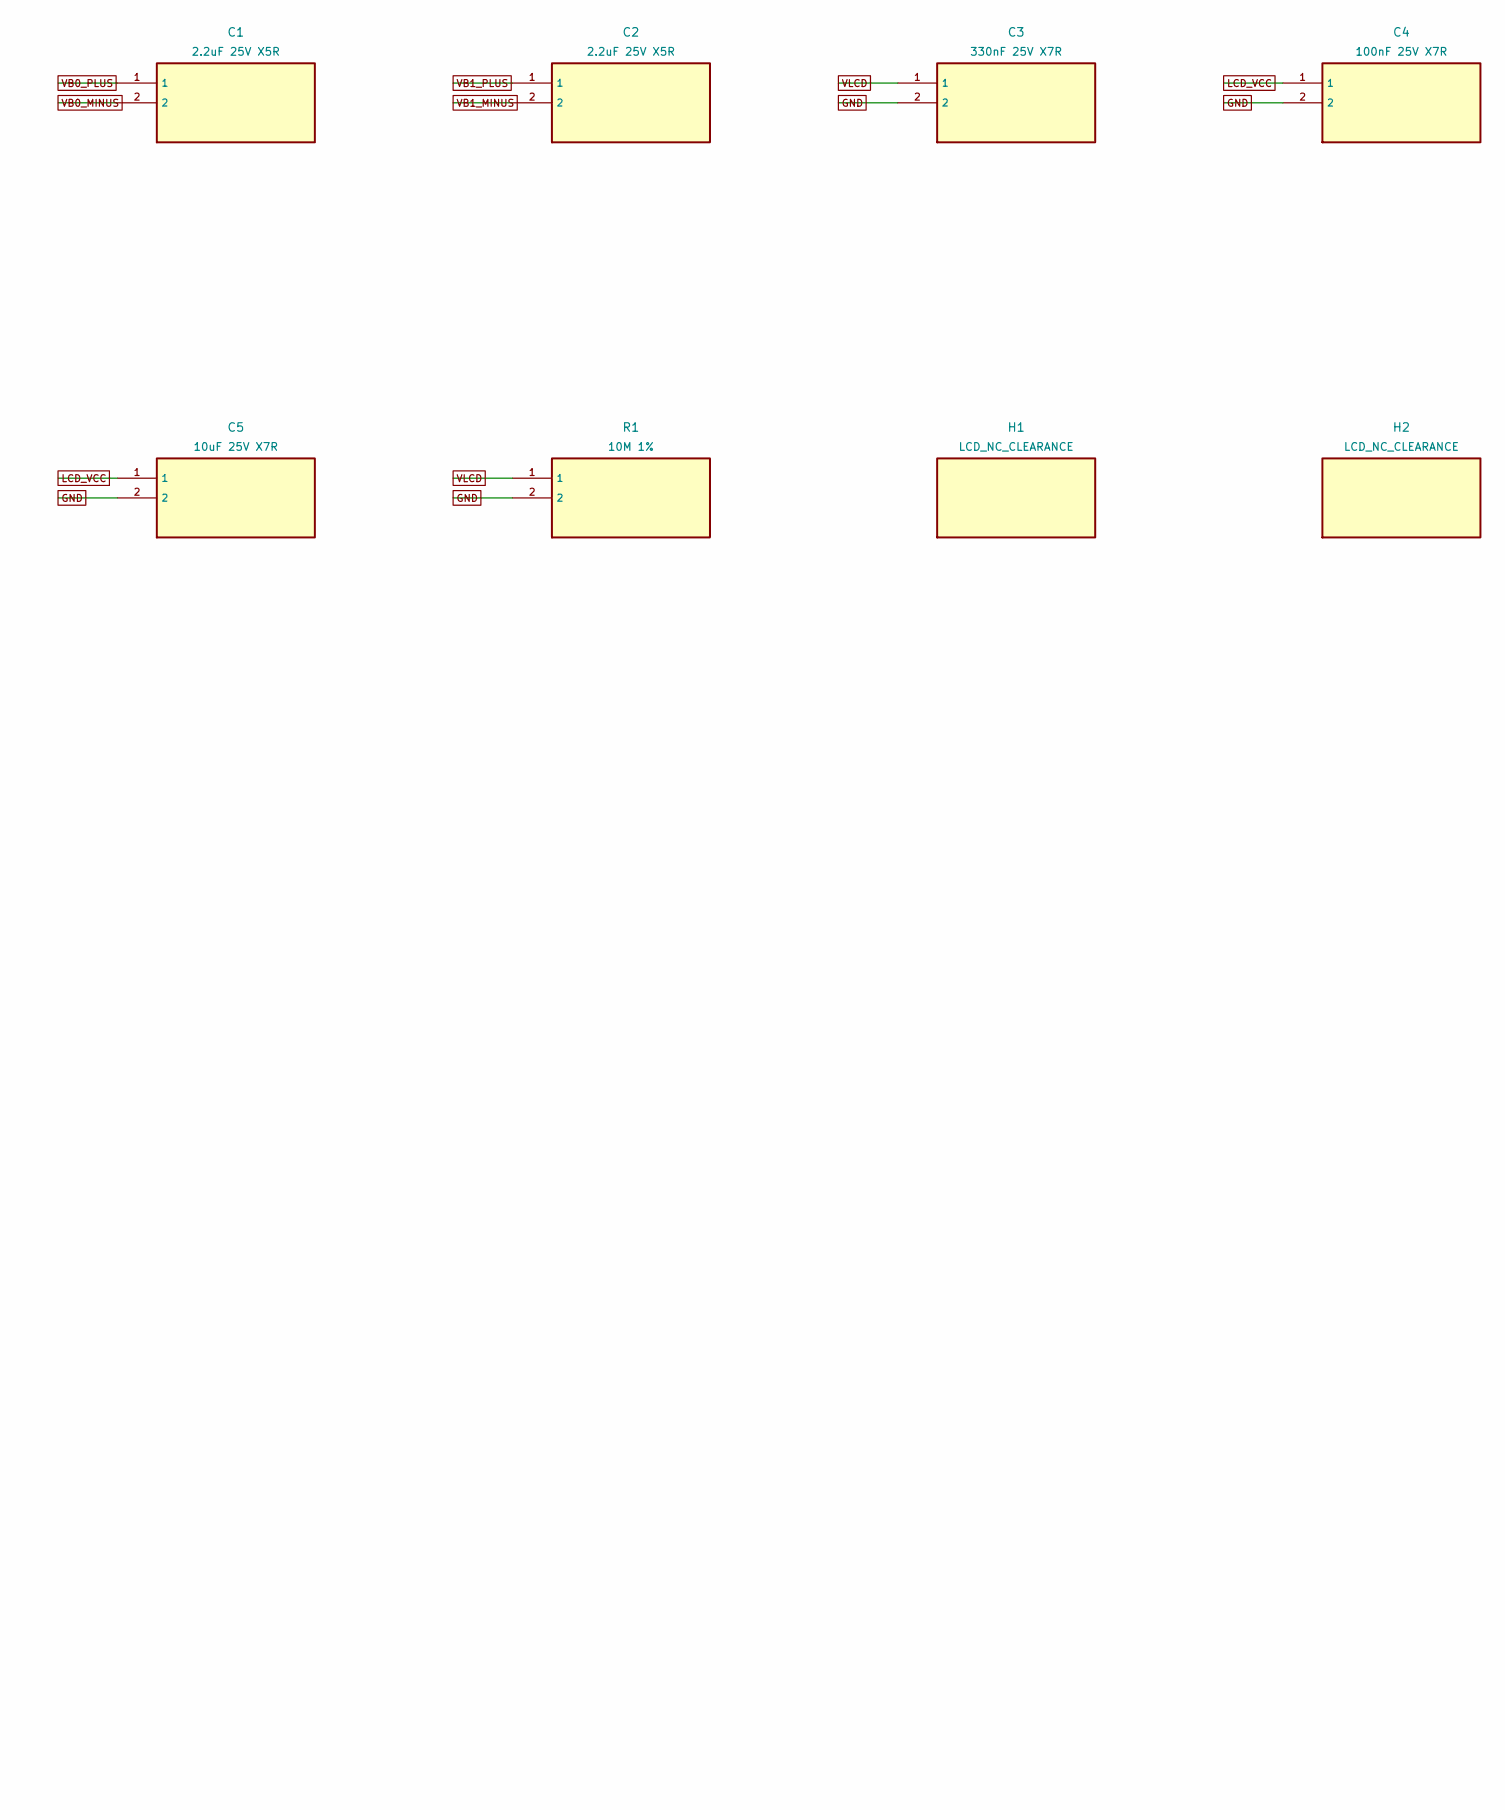
[picture p49: schematic display_adapter.kicad_sch, UC1701 Display Adapter, part in row 1, column 2]

Parts:
C1, C2: 2.2uF 25V X5R; C_0603_1608Metric_Pad1.08x0.95mm_HandSolder
C3: 330nF 25V X7R; C_0603_1608Metric_Pad1.08x0.95mm_HandSolder
C4: 100nF 25V X7R; C_0603_1608Metric_Pad1.08x0.95mm_HandSolder
C5: 10uF 25V X7R; C_1206_3216Metric_Pad1.33x1.80mm_HandSolder
H1, H2: LCD_NC_CLEARANCE; MountingHole_2.1mm
J1: MAIN_J3_CABLE; PinHeader_1x08_P2.54mm_Vertical
J2: ERC12864FS-655; PinHeader_1x22_P1.27mm_Vertical
R1: 10M 1%; R_0603_1608Metric_Pad0.98x0.95mm_HandSolder

Connections:
GND: C3.2, C4.2, C5.2, J1.2, J2.4 (WR0), J2.5 (WR1), J2.6 (D0), J2.7 (D1), J2.8 (D2), J2.9 (D3), J2.10 (D4), J2.11 (D5), J2.15 (VSS), J2.21 (BM0), J2.22 (BM1), R1.2
LCD_CD: J1.6, J2.3 (CD)
LCD_CLK: J1.3, J2.12 (D6_SCK)
LCD_CS: J1.5, J2.1 (CS_N)
LCD_DATA: J1.4, J2.13 (D7_SDA)
LCD_RST: J1.7, J2.2 (RST_N)
LCD_VCC: C4.1, C5.1, J1.1, J2.14 (VDD)
VB0_MINUS: C1.2, J2.17 (VB0_MINUS)
VB0_PLUS: C1.1, J2.16 (VB0_PLUS)
VB1_MINUS: C2.2, J2.18 (VB1_MINUS)
VB1_PLUS: C2.1, J2.19 (VB1_PLUS)
VLCD: C3.1, J2.20 (VLCD), R1.1

Notes on the sheet:
J1 supplies switched 3.3 V and ground from main J3; connect matching pin numbers.
J2 is the LCD pin landing, not a separate header. Verify front-view pin 1.
A/K backlight contacts remain insulated and unconnected.
R3: all passive parts are SMD. C5 is ceramic/nonpolar, not an electrolytic.
Use owned 0603 kits only after rating, dielectric and value qualification.
Prototype: firmware and physical assembly tests pending. See PCB_REVIEW.md.
Power pins on source connectors describe external supplies; Q1 collector is switched power output.

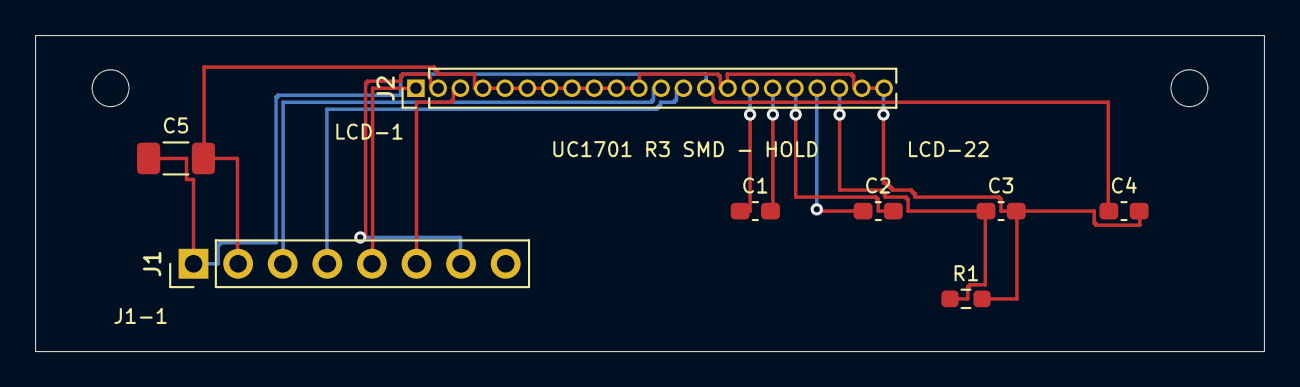
[picture p50: board display_adapter.kicad_pcb from above]

Board: 2 copper layers, 70.0 x 18.0 mm, 10 parts (0 on the bottom side), 12 nets.
