myk410/Material-Weight-Calculator/hardware/source/build_pcb.py

"""Build the KiCad 7 board and connected schematic from one pin/net definition.
Requires pcbnew and standard KiCad footprints. All routing is generated by a two-layer A* router.
"""
from pathlib import Path
import os,math,json,heapq,itertools,uuid,csv,shutil
import pcbnew as k
FP_PLUGIN=k.PCB_IO_KICAD_SEXPR()
ROOT=Path(__file__).resolve().parents[1]; OUT=ROOT/'pcb';OUT.mkdir(exist_ok=True)
LIB=Path(os.environ.get('KICAD_FOOTPRINT_DIR','/usr/share/kicad/footprints'))
b=k.BOARD();settings=b.GetDesignSettings();settings.SetCopperLayerCount(2);settings.m_MinClearance=k.FromMM(.25);settings.m_TrackMinWidth=k.FromMM(.4);settings.m_HoleToHoleMin=k.FromMM(.25);settings.m_CopperEdgeClearance=k.FromMM(.5)
OFF=(50,50); MM=k.FromMM
V=lambda x,y:k.VECTOR2I(MM(x+OFF[0]),MM(y+OFF[1]))
nets={};components=[];pads=[]
def net(name):
 if not name:return None
 if name not in nets:
  nets[name]=k.NETINFO_ITEM(b,name);b.Add(nets[name])
 return nets[name]
def comp(ref,value,library,fp,x,y,pinmap,pinnames=None,angle=0):
 fpdir=OUT/'mw-footprints.pretty' if fp=='C_Radial_L4.5mm_W3.0mm_P2.50mm' else LIB/(library+'.pretty')
 f=FP_PLUGIN.FootprintLoad(str(fpdir),fp,False)
 if f is None:raise RuntimeError(fp)
 f.SetFPIDAsString('MW_footprints:'+fp);f.SetReference(ref);f.SetValue(value);f.SetPosition(V(x,y));f.SetOrientationDegrees(angle)
 local=OUT/'mw-footprints.pretty';local.mkdir(exist_ok=True)
 if fpdir!=local:shutil.copyfile(fpdir/(fp+'.kicad_mod'),local/(fp+'.kicad_mod'))
 f.Reference().SetTextSize(k.VECTOR2I(MM(.9),MM(.9)));f.Reference().SetTextThickness(MM(.15));f.Value().SetVisible(False)
 b.Add(f)
 rec={'ref':ref,'value':value,'footprint':'MW_footprints:'+fp,'x':x,'y':y,'angle':angle,'pins':{},'pin_names':pinnames or {}}
 for p in f.Pads():
  num=p.GetNumber();n=pinmap.get(num,'')
  if n:p.SetNet(net(n))
  pos=p.GetPosition();sx,sy=p.GetSize().x/1e6,p.GetSize().y/1e6
  # Conservatively treat rectangular and oval pads by their circumscribed disk.
  radius=math.hypot(sx,sy)/2 if p.GetShape()==k.PAD_SHAPE_RECT else max(sx,sy)/2
  pads.append({'ref':ref,'pin':num,'x':pos.x/1e6-OFF[0],'y':pos.y/1e6-OFF[1],'r':radius,'net':n,'drill':p.GetDrillSize().x/1e6})
  rec['pins'][num]=n
 components.append(rec);return f
# Common connector footprint orientation: pad numbers increase downward in PCB plan.
U1={'1':'','2':'ROW0','3':'ROW1','4':'ROW2','5':'ROW3','6':'COL0','7':'COL1','8':'COL2','9':'COL3','10':'','11':'','12':'','13':'LCD_PWR_CTRL','14':'+3V3','15':'GND','16':'','17':'','18':'','19':'UPDI','20':'+3V3','21':'GND','22':'','23':'LCD_CLK','24':'LCD_DATA','25':'LCD_CS','26':'LCD_CD','27':'LCD_RST','28':''}
labels=['PA7','PC0','PC1','PC2','PC3','PD0','PD1','PD2','PD3','PD4','PD5','PD6','PD7','AVDD','GND','PF0','PF1','PF6_RESET','UPDI','VDD','GND','PA0','PA1','PA2','PA3','PA4','PA5','PA6']
comp('U1','AVR128DA28-I/SP','Package_DIP','DIP-28_W7.62mm',35,20,U1,{str(i+1):s for i,s in enumerate(labels)})
comp('J1','KEYPAD_8PIN','Connector_PinHeader_2.54mm','PinHeader_1x08_P2.54mm_Vertical',12,22.54,{str(i+1):n for i,n in enumerate(['ROW0','ROW1','ROW2','ROW3','COL0','COL1','COL2','COL3'])})
comp('J2','BATTERY_3AAA','Connector_PinHeader_2.54mm','PinHeader_1x02_P2.54mm_Vertical',10,9,{'1':'BAT_PLUS','2':'GND'},{'1':'BAT+','2':'BAT-'})
comp('JP1','MASTER_LINK','Connector_PinHeader_2.54mm','PinHeader_1x02_P2.54mm_Vertical',19,9,{'1':'BAT_PLUS','2':'BAT_SWITCH'})
comp('D1','1N5817','Diode_THT','D_DO-41_SOD81_P7.62mm_Horizontal',24,9,{'1':'VIN','2':'BAT_SWITCH'},{'1':'K','2':'A'})
comp('U2','MCP1700-3302E/TO','Package_TO_SOT_THT','TO-92_Inline_Wide',23,15,{'1':'GND','2':'VIN','3':'+3V3'},{'1':'GND','2':'VIN','3':'VOUT'})
for ref,value,x,y,n in [('C1','2.2uF 50V X7R',23,20,'VIN'),('C2','2.2uF 50V X7R',29,20,'+3V3'),('C3','100nF 10V',47,39,'+3V3'),('C4','100nF 10V',34,58,'+3V3'),('C5','2.2uF 50V X7R',64,12,'LCD_VCC')]:
 comp(ref,value,'Capacitor_THT','C_Radial_L4.5mm_W3.0mm_P2.50mm' if ref in ['C1','C2','C5'] else 'C_Disc_D3.0mm_W1.6mm_P2.50mm',x,y,{'1':n,'2':'GND'})
comp('Q1','onsemi 2N3906 EBC','Package_TO_SOT_THT','TO-92_Inline_Wide',56,15,{'1':'+3V3','2':'LCD_BASE','3':'LCD_VCC'},{'1':'E','2':'B','3':'C'})
comp('R1','10k','Resistor_THT','R_Axial_DIN0207_L6.3mm_D2.5mm_P7.62mm_Horizontal',50,22,{'1':'LCD_PWR_CTRL','2':'LCD_BASE'})
comp('R2','100k','Resistor_THT','R_Axial_DIN0207_L6.3mm_D2.5mm_P7.62mm_Horizontal',56,7,{'1':'+3V3','2':'LCD_BASE'})
comp('J3','UC1701_ADAPTER_CABLE','Connector_PinHeader_2.54mm','PinHeader_1x08_P2.54mm_Vertical',70,16,{str(i+1):n for i,n in enumerate(['LCD_VCC','GND','LCD_CLK','LCD_DATA','LCD_CS','LCD_CD','LCD_RST',''])},{str(i+1):n for i,n in enumerate(['VCC','GND','SCK','SDA','CS_N','CD','RST_N','NC'])})
comp('J4','UPDI_3V3','Connector_PinHeader_2.54mm','PinHeader_1x03_P2.54mm_Vertical',55,46,{'1':'+3V3','2':'GND','3':'UPDI'},{'1':'VTREF','2':'GND','3':'UPDI'})
for i,(x,y) in enumerate([(5,5),(77,5),(5,63),(77,63)]):
 f=comp(f'H{i+1}','M2.5','MountingHole','MountingHole_2.7mm_M2.5',x,y,{})
# Outline.
for a,c in [((0,0),(82,0)),((82,0),(82,68)),((82,68),(0,68)),((0,68),(0,0))]:
 s=k.PCB_SHAPE();s.SetShape(k.SHAPE_T_SEGMENT);s.SetStart(V(*a));s.SetEnd(V(*c));s.SetLayer(k.Edge_Cuts);s.SetWidth(MM(.05));b.Add(s)
# Text labels clear of component bodies; pin 1s remain marked by standard footprints.
def text(t,x,y,size=1,layer=k.F_SilkS):
 o=k.PCB_TEXT(b);o.SetText(t);o.SetPosition(V(x,y));o.SetTextSize(k.VECTOR2I(MM(size),MM(size)));o.SetTextThickness(MM(.15));o.SetLayer(layer);b.Add(o)
text('MATERIAL WEIGHT R2',40,3,1.3);text('3xAAA ONLY  /  3V3',41,65,1);text('J3: UC1701 8-WIRE',68,43,.85)
# Router grid in mm. Trace width .4 mm; design clearance .25 mm.
GRID=.254;NX=int(82/GRID)+1;NY=int(68/GRID)+1;N=NX*NY
owners=[[0]*N for _ in range(2)]; codes={n:i+1 for i,n in enumerate(nets)};trackwidth=.4;clearance=.25
routes=[];vias=[]
def grid(x,y):return round(x/GRID),round(y/GRID)
def stamp(layer,x,y,r,code):
 gx,gy=grid(x,y);rn=math.ceil(r/GRID)+1
 for yy in range(max(0,gy-rn),min(NY,gy+rn+1)):
  for xx in range(max(0,gx-rn),min(NX,gx+rn+1)):
   if math.hypot(xx*GRID-x,yy*GRID-y)<=r:
    idx=yy*NX+xx
    if owners[layer][idx] not in (0,code):owners[layer][idx]=-1
    else:owners[layer][idx]=code
for l in (0,1):
 for y in range(NY):
  for x in range(NX):
   if x*GRID<.8 or x*GRID>81.2 or y*GRID<.8 or y*GRID>67.2:owners[l][y*NX+x]=-1
for p in pads:
 code=codes.get(p['net'],-1)
 for l in (0,1):stamp(l,p['x'],p['y'],p['r']+trackwidth/2+clearance+.025,code)
def canvia(gx,gy,code):
 for l in (0,1):
  for dx,dy in [(0,0),(1,0),(-1,0),(0,1),(0,-1),(1,1),(-1,1),(1,-1),(-1,-1)]:
   x,y=gx+dx,gy+dy
   if x<0 or y<0 or x>=NX or y>=NY or owners[l][y*NX+x] not in (0,code):return False
 return True
def astar(a,c,code):
 sx,sy=grid(a['x'],a['y']);tx,ty=grid(c['x'],c['y'])
 # Through-hole pads connect both layers. Routing can start/end on either.
 targets={ty*NX+tx,N+ty*NX+tx}
 q=[];cost={};prev={};count=itertools.count()
 for l in (0,1):
  v=l*N+sy*NX+sx;cost[v]=0;heapq.heappush(q,(abs(sx-tx)+abs(sy-ty),next(count),v))
 while q:
  _,_,v=heapq.heappop(q)
  if v in targets:
   seq=[]
   while v in prev:seq.append(v);v=prev[v]
   seq.append(v);return seq[::-1]
  l=v//N;idx=v%N;x=idx%NX;y=idx//NX;g=cost[v]
  for dx,dy in [(1,0),(-1,0),(0,1),(0,-1)]:
   xx,yy=x+dx,y+dy
   if not(0<=xx<NX and 0<=yy<NY):continue
   u=l*N+yy*NX+xx
   if owners[l][yy*NX+xx] not in (0,code):continue
   ng=g+1
   if ng<cost.get(u,1e20):cost[u]=ng;prev[u]=v;heapq.heappush(q,(ng+abs(xx-tx)+abs(yy-ty),next(count),u))
  if canvia(x,y,code):
   u=(1-l)*N+idx;ng=g+15
   if ng<cost.get(u,1e20):cost[u]=ng;prev[u]=v;heapq.heappush(q,(ng+abs(x-tx)+abs(y-ty),next(count),u))
 raise RuntimeError(f'Cannot route {a} -> {c}')
def segment(a,c,layer,name):
 if math.dist(a,c)<.00001:return
 s=k.PCB_TRACK(b);s.SetStart(V(*a));s.SetEnd(V(*c));s.SetWidth(MM(trackwidth));s.SetLayer(k.F_Cu if layer==0 else k.B_Cu);s.SetNet(nets[name]);b.Add(s)
 routes.append({'net':name,'layer':layer,'a':a,'b':c,'width':trackwidth})
 d=math.dist(a,c);steps=max(1,math.ceil(d/(GRID/2)))
 for i in range(steps+1):
  t=i/steps;stamp(layer,a[0]+t*(c[0]-a[0]),a[1]+t*(c[1]-a[1]),trackwidth+clearance+.025,codes[name])
def route(a,c,name):
 seq=astar(a,c,codes[name]);points=[(v//N,((v%N)%NX)*GRID,((v%N)//NX)*GRID) for v in seq]
 # Exact pad-center endpoints avoid off-grid disconnects.
 points=[(points[0][0],a['x'],a['y'])]+points+[(points[-1][0],c['x'],c['y'])]
 last=points[0];direction=None;anchor=last
 for p in points[1:]:
  if p[0]!=last[0]:
   segment(anchor[1:],last[1:],last[0],name)
   via=k.PCB_VIA(b);via.SetPosition(V(last[1],last[2]));via.SetWidth(MM(1.0));via.SetDrill(MM(.5));via.SetViaType(k.VIATYPE_THROUGH);via.SetLayerPair(k.F_Cu,k.B_Cu);via.SetNet(nets[name]);b.Add(via)
   vias.append({'x':last[1],'y':last[2],'net':name})
   for l in (0,1):stamp(l,last[1],last[2],.5+trackwidth/2+clearance+.025,codes[name])
   anchor=p;direction=None
  else:
   dx=round(p[1]-last[1],6);dy=round(p[2]-last[2],6)
   nd=(0 if abs(dx)<1e-5 else math.copysign(1,dx),0 if abs(dy)<1e-5 else math.copysign(1,dy))
   if direction is not None and nd!=direction:segment(anchor[1:],last[1:],last[0],name);anchor=last
   if nd!=(0,0):direction=nd
  last=p
 segment(anchor[1:],last[1:],last[0],name)
for name in sorted(nets,key=lambda n:(n in ['+3V3','GND'],len([p for p in pads if p['net']==n]))):
 todo=[p for p in pads if p['net']==name]
 if not todo:continue
 done=[todo.pop(0)]
 while todo:
  _,i,j=min((math.dist((a['x'],a['y']),(c['x'],c['y'])),i,j) for i,a in enumerate(done) for j,c in enumerate(todo))
  c=todo.pop(j);route(done[i],c,name);done.append(c)
 print('Routed',name,flush=True)
k.SaveBoard(str(OUT/'material_weight_calculator.kicad_pcb'),b)
(ROOT/'source'/'electrical_design.json').write_text(json.dumps({'board_size_mm':[82,68],'components':components,'pads':pads,'routes':routes,'vias':vias,'trace_width_mm':trackwidth,'clearance_mm':clearance},indent=2))
(OUT/'fp-lib-table').write_text('(fp_lib_table (lib (name MW_footprints)(type KiCad)(uri ${KIPRJMOD}/mw-footprints.pretty)(options \"\")(descr \"Bundled standard KiCad footprints\")))')
# Basic project settings; current design rules are deliberately generous for etching.
(OUT/'material_weight_calculator.kicad_pro').write_text(json.dumps({'meta':{'filename':'material_weight_calculator.kicad_pro','version':1},'board':{'design_settings':{'rules':{'min_clearance':.25,'min_track_width':.4,'min_via_diameter':1,'min_through_hole_diameter':.5,'min_hole_to_hole':.25},'defaults':{'copper_line_width':.4}}},'net_settings':{'classes':[{'name':'Default','clearance':.25,'track_width':.4,'via_diameter':1,'via_drill':.5,'microvia_diameter':.3,'microvia_drill':.1,'bus_width':12,'line_style':0,'pcb_color':'rgba(0, 0, 0, 0.000)','schematic_color':'rgba(0, 0, 0, 0.000)','wire_width':6}],'meta':{'version':3}}},indent=2))
# Single embedded symbol per physical component with explicit pin names and local net labels.
def uid():return str(uuid.uuid4())
def esc(s):return str(s).replace('\\','\\\\').replace('"','\\"')
rootid=uid();lib=[];instances=[];wires=[]
# Schematic grid positions are selected for readable, non-overlapping groups on A3.
positions={'U1':(85,91),'J1':(40,68),'J2':(40,25),'JP1':(75,25),'D1':(111,25),'U2':(151,25),'C1':(190,25),'C2':(225,25),'Q1':(261,25),'R1':(299,25),'R2':(336,25),'C5':(372,25),'J3':(205,88),'J4':(265,88),'C3':(315,88),'C4':(355,88)}
for c in components:
 if c['ref'].startswith('H'):continue
 ref=c['ref'];pins=c['pins'];length=len(pins);left=length if length<10 else length//2;right=length-left
 boxh=max(10,(max(left,right)+1)*2.54);half=9
 pinstr=[]
 for idx,num in enumerate(sorted(pins,key=lambda x:int(x))):
  side=idx<left;ix=idx if side else idx-left
  yy=boxh/2-(ix+1)*2.54;xx=-14.08 if side else 14.08;ang=0 if side else 180
  name=c['pin_names'].get(num,num)
  pinstr.append(f'(pin passive line (at {xx} {yy} {ang}) (length 5.08) (name "{esc(name)}" (effects (font (size .9 .9)))) (number "{num}" (effects (font (size .9 .9)))))')
 symname='MW_'+ref
 lib.append(f'(symbol "MW:{symname}" (pin_names (offset .508)) (in_bom yes) (on_board yes) (property "Reference" "{ref}" (at 0 {boxh/2+4} 0) (effects (font (size 1 1)))) (property "Value" "{esc(c["value"])}" (at 0 {boxh/2+1.5} 0) (effects (font (size 1 1)))) (symbol "{symname}_0_1" (rectangle (start {-half} {-boxh/2}) (end {half} {boxh/2}) (stroke (width .254) (type default)) (fill (type background)))) (symbol "{symname}_1_1" {" ".join(pinstr)}))')
 x,y=positions[ref];iid=uid()
 props=f'(property "Reference" "{ref}" (at {x} {y-boxh/2-4} 0) (effects (font (size 1.1 1.1)))) (property "Value" "{esc(c["value"])}" (at {x} {y-boxh/2-1.5} 0) (effects (font (size 1 1)))) (property "Footprint" "{c["footprint"]}" (at {x} {y} 0) (effects (font (size 1 1)) hide))'
 instpins=' '.join(f'(pin "{n}" (uuid {uid()}))' for n in pins)
 instances.append(f'(symbol (lib_id "MW:{symname}") (at {x} {y} 0) (unit 1) (in_bom yes) (on_board yes) (uuid {iid}) {props} {instpins})')
 # KiCad screen Y is inverted relative to symbol-local Y.
 for idx,num in enumerate(sorted(pins,key=lambda x:int(x))):
  side=idx<left;ix=idx if side else idx-left;yy=y-boxh/2+(ix+1)*2.54;xx=x+(-14.08 if side else 14.08);n=pins[num]
  if n:
   endx=xx+(-6 if side else 6)
   wires.append(f'(wire (pts (xy {xx} {yy}) (xy {endx} {yy})) (stroke (width 0) (type default)) (uuid {uid()}))')
   wires.append(f'(label "{n}" (at {endx} {yy} 0) (effects (font (size .9 .9)) (justify {"right" if side else "left"} bottom)) (uuid {uid()}))')
  else:wires.append(f'(no_connect (at {xx} {yy}) (uuid {uid()}))')
 c['schematic_uuid']=iid
paths=' '.join(f'(path "/{c["schematic_uuid"]}" (reference "{c["ref"]}") (unit 1) (value "{esc(c["value"])}") (footprint "{c["footprint"]}"))' for c in components if not c['ref'].startswith('H'))
sch=f'(kicad_sch (version 20230121) (generator eeschema) (uuid {rootid}) (paper "A3") (title_block (title "Material Weight Calculator") (date "2026-10-27") (rev "R2") (comment 1 "Prototype - see hardware/README.md")) (lib_symbols {" ".join(lib)}) {" ".join(wires)} {" ".join(instances)} (sheet_instances (path "/" (page "1"))) (symbol_instances {paths}))'
(OUT/'material_weight_calculator.kicad_sch').write_text(sch)
with (OUT/'bom.csv').open('w',newline='') as f:
 w=csv.writer(f);w.writerow(['Reference','Value','Footprint']);w.writerows((c['ref'],c['value'],c['footprint']) for c in components)
for footprint in b.GetFootprints():
 for c in components:
  if c['ref']==footprint.GetReference() and 'schematic_uuid' in c:footprint.SetPath(k.KIID_PATH('/'+c['schematic_uuid']))
k.SaveBoard(str(OUT/'material_weight_calculator.kicad_pcb'),b)
b.BuildConnectivity()
k.WriteDRCReport(b,str(ROOT/'validation'/'kicad_drc_initial.rpt'),k.EDA_UNITS_MILLIMETRES,True)
print('PCB COMPLETE',len(routes),'segments',len(vias),'vias',flush=True)
# Apply the reviewed symbol types, global nets and explicit NC nets after routing.
from refresh_schematics import refresh
refresh(False)
