myk410/Material-Weight-Calculator/(commit log)

2026-10-27 Document low-power AAA material weight calculator design
2026-10-27 Replace card densities with published grade-specific material presets
2026-10-27 Specify resin housing and flexible buttons with recessed legends
2026-10-27 Add resin enclosure, engraved buttons, and routed PCB fabrication package
    [all_16_buttons.stl, battery_cover.stl, bom.csv, button_r1c1_7.stl, button_r1c2_8.stl, button_r1c3_9.stl, button_r1c4_menu.stl, button_r2c1_4.stl]
2026-10-27 Revise calculator for 2.8-inch UC1701 display with adapter PCB and larger resin bezel
    Replace the Sharp display with ERC12864FS-655. Regenerate CAD, STLs, schematics, routed PCBs, Gerbers, drills, print templates and R2 download packages. Preserve the 4x4 keypad and AAA supply. Verify both PCB DRC reports, manufacturer pin map, closed meshes, nominal fit and package checksums. Physical testing and device firmware remain pending.
    [bom.csv, calculator_assembly.step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]
2026-10-30 Specify screwless resin-friendly battery door
2026-10-30 Require anti-warp ribs and screwless battery door
2026-10-30 Add CAD regeneration workflow for battery door
2026-10-30 Add screwless battery door CAD generator
2026-10-30 Regenerate screwless battery door STLs
    [battery_cover.stl, mars_rear_lower.stl, rear_shell_whole_reference.stl]
2026-11-02 Add CYT1107 hardware power switch mount to rear shell
2026-11-02 Record CYT1107 hard power switch dimensions and wiring
2026-11-02 Document CYT1107 hard power switch integration
2026-11-02 Fix switch recess fillet for CAD regeneration
2026-11-02 Audit PCB R2.1, integrate hard power switch and correct capacitor footprints
    [bom.csv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]
2026-11-12 Add physical mating orientation gate and fabrication hold for PCB R2.1
2026-11-12 Add independent pin numbering and orientation regression test
2026-11-12 Flag PCB R2.1 fabrication hold pending physical connector orientation verification
2026-11-12 Clarify actual membrane female socket and PCB J1 male header mating requirements
2026-11-12 Document 8-pin female membrane to male J1 header, dimensions and orientation validation
2026-11-12 Identify keypad male header purchase and physical mating verification in BOM
2026-11-12 Record verified DIYmalls keypad listing and 2.54 mm connector specification
2026-11-12 Constrain R3 buck-boost to soldering-iron assembly and select preassembled module candidate
2026-11-12 Prefer LTC3440 MSOP hand-solderable SMD buck-boost for R3 power design
2026-11-12 Add LTC3440 R3 reference circuit and orientation validation: power_r3_reference.json
2026-11-12 Add LTC3440 R3 reference circuit and orientation validation: power_r3_bom.csv
    [power_r3_bom.csv]
2026-11-12 Add LTC3440 R3 reference circuit and orientation validation: check_power_r3.py
2026-11-12 Add LTC3440 R3 reference circuit and orientation validation: POWER_R3_IMPLEMENTATION.md
2026-11-12 Explicitly block old Gerbers after R3 LTC3440 redesign specification
2026-11-12 Implement CAD-validated R3 LTC3440 supply and enforce physical fabrication hold
    Route the MSOP-10 buck-boost supply with hand-solder pads, correct VC-to-FB compensation, and high-input protection. Preserve all connector and socket coordinates; include numbered top/underside templates, BOM, manufacturer references and reproducible checks.
    KiCad 9 ERC, DRC and schematic parity pass for both boards with zero violations and unconnected pads. Independent pad/net/orientation checks and negative tests pass. Physical mating, populated fit, capacitance qualification and bench testing remain open. No R3 Gerbers, drills or fabrication ZIP are released.
    [bom.csv, material_weight_calculator.kicad_pcb, material_weight_calculator.kicad_sch, orientation_pins.csv, power_r3_bom.csv]
2026-11-12 Use SMD discretes on both R3 boards while retaining purchased AVR socket and interfaces
    Convert remaining main-board and adapter resistors/capacitors to hand-solder SMD footprints, including 0603 footprints for suitable owned kit parts. Use MMBT3906 SOT-23 with independently verified B/E/C pin numbering. Retain the purchased AVR DIP/socket, display and all connector coordinates.
    Both R3 boards pass KiCad ERC, DRC and schematic parity with zero violations. Actual-pad audit enforces SMD discrete parts on both boards and unchanged DIP/connector contracts. Negative tests catch B/E swaps and prevent manufacturing output while physical qualification is unresolved. Gerbers remain withheld.
    [bom.csv, display_adapter.kicad_pcb, display_adapter.kicad_sch, material_weight_calculator.kicad_pcb, material_weight_calculator.kicad_sch, orientation_pins.csv]
2026-11-12 Add JST-PH programming socket for the existing UPDI Friend cable
    Add J5, a keyed 3-pin 2mm PH header: 1 GND, 2 regulated 3.3V power, 3 UPDI to MCU pin 19. Retain original J4, purchased DIP socket and existing connector positions. Crimp PH contacts onto the loose ends of the existing programmer cable; no separate adapter or programmer soldering is required.
    Both boards pass native KiCad ERC, DRC and schematic parity with zero violations. Add independent PH pin/pitch/orientation checks and negative tests for connector reversal and power/ground swaps. Include updated wiring guide, BOM and top/underside templates. Physical cable/kit mating checks remain open; Gerbers are withheld.
    [bom.csv, material_weight_calculator.kicad_pcb, material_weight_calculator.kicad_sch, orientation_pins.csv]
